cavesLezet/buoy_v2/README.md

# buoy_v2
версия 2 с нагревом панелей и 100500 датчиками температуры
