cavesLezet/buoy_v2/моделирование заряда затвора/Новый точечный рисунок (2).bmp

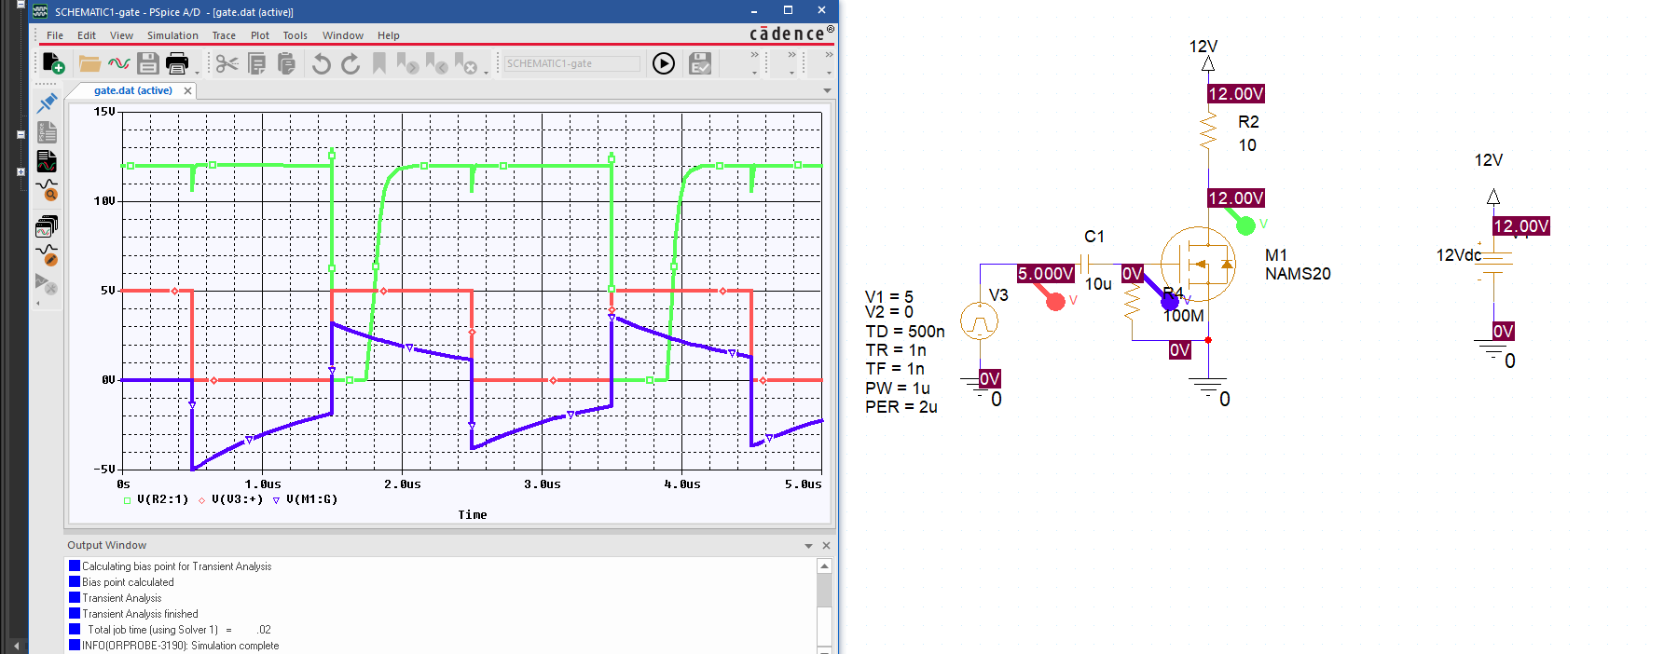
моделирование заряда затвора/Новый точечный рисунок (2).bmp
