cavesLezet/buoy_v2/моделирование заряда затвора/Новый точечный рисунок.bmp

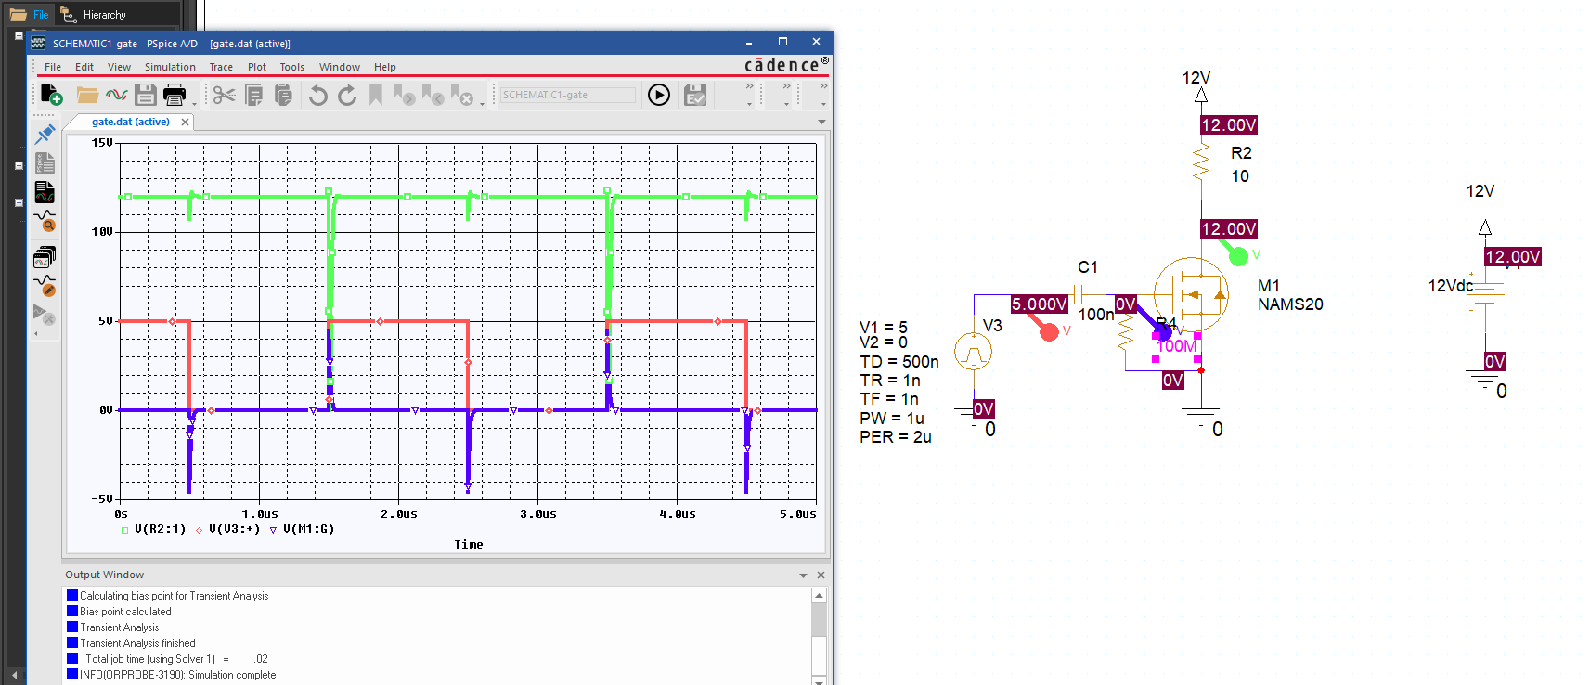
моделирование заряда затвора/Новый точечный рисунок.bmp
