cavesLezet/buoy_v2/моделирование источника тока на тл431/TL431.png

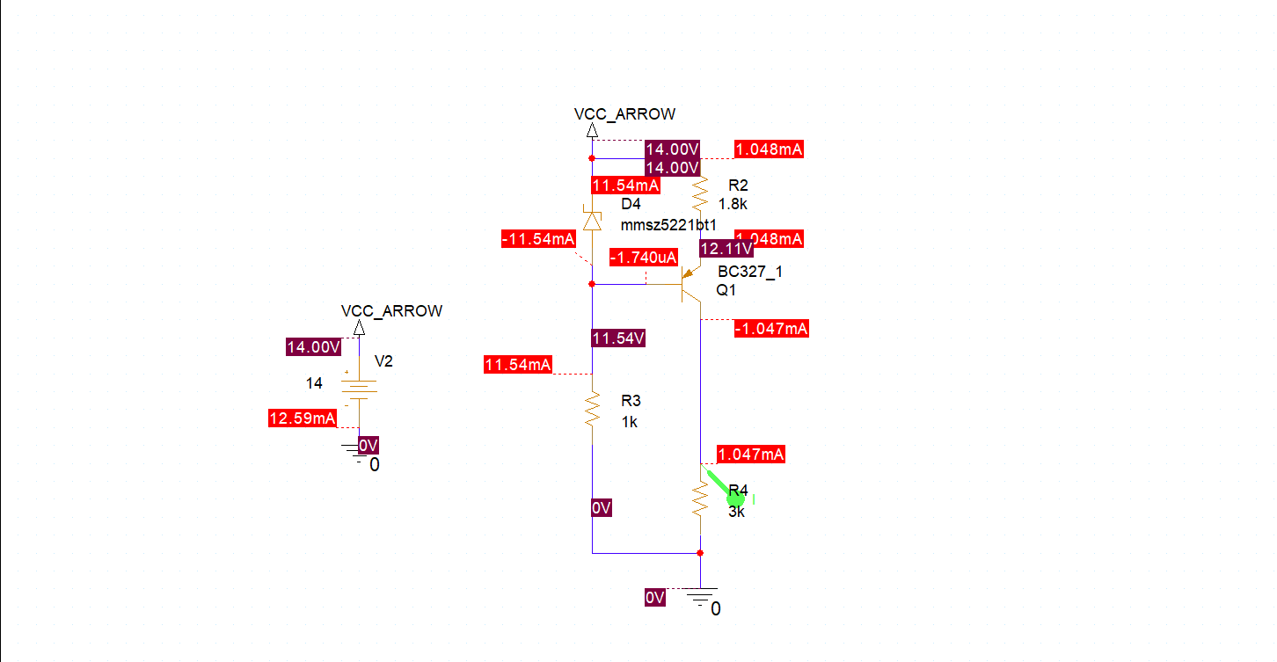
моделирование источника тока на тл431/TL431.png
