cavesLezet/buoy_v2/моделирование источника тока на тл431/Безымянный.png

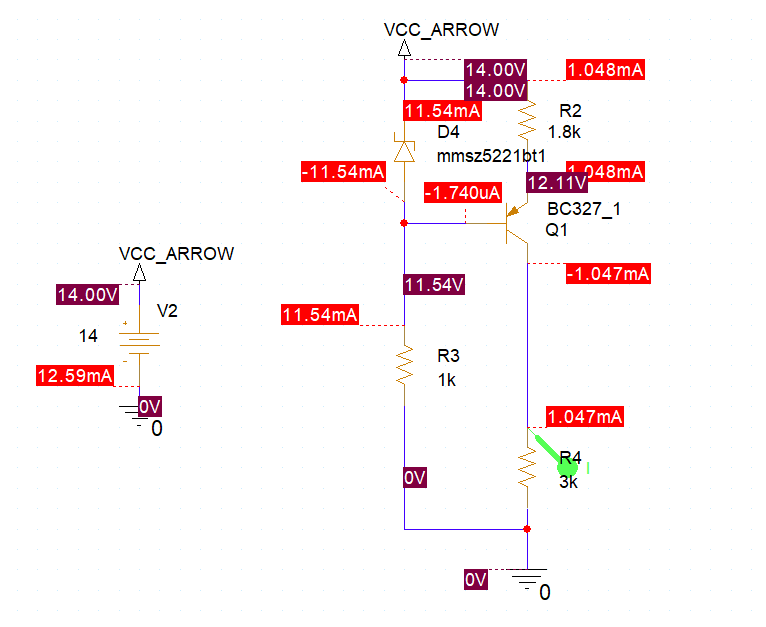
моделирование источника тока на тл431/Безымянный.png
