cavesLezet/buoy_v2/Project Outputs for buoy_v2.0_AA/buoy_v2.0_AA.xlsx

Part Number | Value | Footprint | Line # | Name | Description | Designator | Quantity | Manufacturer 1 | Manufacturer Part Number 1 | Manufacturer Lifecycle 1 | Supplier 1 | Supplier Part Number 1 | Supplier Unit Price 1 | Supplier Subtotal 1
10S45SP |  | TO-277 |  | 10S45SP | Диод шоттки на 45 В, ном. ток 10 А | VD19 | 1
15MQ040N |  | SMA |  | 15MQ040N | Диод шоттки на 40 В, ном. ток 2.1 А | VD14, VD16, VD17 | 3
74HC4051PW,118 |  | TSSOP-16 |  | 74HC4051PW,118 | Мультиплексор аналоговый 8 в 1 КМОП кристалл, TSSOP16 | DD7 | 1
ADM2483BRWZ |  | SOIC-16W |  | ADM2483BRWZ | Прием передатчик RS485 с гальванической развязкой | DD6 | 1
arduino_nano |  | arduino_nano |  | arduino_nano | ардуинка на стойках | DD2 | 1
B82462G4223M | 22 мк | B82462G4 |  | B82462G4223M | ЧИП-индуктивность 22мкГн, 1.05A, ±20% катушка | L2, L3, L5, L6 | 4
BAT54WS |  | SOD-323 |  | BAT54WS | Диод шоттки на 30 В, ном. ток 0.2 А | VD15, VD18 | 2
bc807 |  | SOT23-3 |  | bc807 | Биполярный транзистор PNP 45В 0.5А 0.31Вт | VT1 | 1
BZV55B2V4 | 2.4 В | mini_MELF_3.5mm |  | BZV55B2V4 | Стабилитрон на 2.4 В, рассеиваемая мощность 0.5 Вт | VD3 | 1
Capacitor_0,1u_10_50V_X7R_0603C | 0,1 мк | 0603C |  | Capacitor | Конденсатор | C3, C6, C7, C8, C9, C10, C11, C12, C13, C14, C16 | 11
Capacitor_1n_10_50V_X7R_0603C | 1 н | 0603C |  | Capacitor | Конденсатор | C27_1, C27_2, C27_3 | 3
Capacitor_1u_10_50V_X7R_0603C | 1 мк | 0603C |  | Capacitor | Конденсатор | C15, C24_1, C24_2, C24_3, C25_1, C25_2, C25_3 | 7
Capacitor_4,7u_10_50V_X7R_1206C | 4,7 мк | 1206C |  | Capacitor | Конденсатор | C28, C31, C33, C34, C37, C40, C42, C43 | 8
Capacitor_10n_10_50V_X7R_0603C | 10 н | 0603C |  | Capacitor | Конденсатор | C32, C41 | 2
Capacitor_10u_10_35V_X7R_1210C | 10 мк | 1210C |  | Capacitor | Конденсатор | C17_1, C17_2, C17_3, C18_1, C18_2, C18_3, C19_1, C19_2, C19_3, C20_1, C20_2, C20_3, C21_1, C21_2, C21_3, C22_1, C22_2, C22_3, C23_1, C23_2, C23_3 | 21
Capacitor_22u_10_25V_X7R_1210C | 22 мк | 1210C |  | Capacitor | Конденсатор | C2, C5, C29, C30, C35, C36, C38, C39, C44, C45 | 10
Capacitor_33n_10_50V_X7R_0603C | 33 н | 0603C |  | Capacitor | Конденсатор | C26_1, C26_2, C26_3 | 3
Capacitor_2200u_10V_10x20 | 2200 мк | 10x20_radial |  | Capacitor | Конденсатор радиальный 2200мкФ 10В ±20% 10*19 | C4 | 1
DHT22 |  | DHT22 |  | DHT22 | Датчик температуры и влажности на базе AM2302 | DD8 | 1
DIN41612_32_2row_right_angle_father |  | DIN41612_32_2row_right_angle_father |  | DIN41612_32_2row_right_angle_father | DIN41612R (DS1118-32M0R23), Разъем (вилка) тип B 32pin (2х16), шаг 2.54мм двухрядный угловой (ряд АВ) | XP1 | 1
EEVFK1E102Q | 1000 мк | SMD_cap_12,5x13,5 |  | Capacitor | Конденсатор алюминиевый электролитический 1000мкФ 25В 20% Low ESR 1100мА SMD12.5x13.5мм | C1 | 1
Fuse 20x5 on clips FC-M | {Номинал} | fuse_20x5_on_clips_FC-M |  | Fuse 20x5 on clips FC-M | Предохранитель 20*5 на креплениях | F1 | 1
IHLP2525CZER4R7M01 | 4,7 мк | IHLP-2525 |  | IHLP2525CZER4R7M01 | ЧИП-индуктивность экранированная 4,7мкГн ±20% 5,5A 40мОм 2525 | L1_1, L1_2, L1_3 | 3
IHLP4040DZER220M11 | 22 мк | IHLP-4040 |  | IHLP4040DZER220M11 | ЧИП-индуктивность экранированная 22мкГн ±20% 5A 66мОм 4040 лента на катушке | L4 | 1
IHLP4040DZER330M11 | 33 мк | IHLP-4040 |  | IHLP4040DZER330M11 | ЧИП-индуктивность экранированная 33мкГн ±20% 4,4A 94,5мОм 4040 | L7 | 1
MAX485CSA |  | SOIC-8 |  | MAX485CSA | RS-485 приёмопередатчик | DD4 | 1
MC74HC595ADR2G |  | SOIC-16 |  | MC74HC595ADR2G | 8-ми битный сдвиговый регистр | DD3, DD5 | 2
MT3608 |  | SOT23-6 |  | MT3608 | Повышающий/SEPIC DC-DC преобразователь 2А 1.2МГц | DD9, DD10 | 2
PESD5V0S1UB | 5 В | SOD523 |  | PESD5V0S1UB | Защитный диод на 5 В, рассеиваемая мощность 330 Вт | VD2, VD4, VD5, VD6, VD7, VD8, VD10, VD13_1, VD13_2, VD13_3, VD13_4, VD13_5, VD13_6, VD13_7 | 14
PSM712 |  | SOT23-3 |  | PSM712 | Защитный диод для линии RS-485 | D1, D2 | 2
Resistor_1.0k_1_0603 | 1,0 к | 0603R |  | Resistor | Резистор номиналом 1,0 кОм и точностью 1% | R1, R4, R10, R25, R26, R33_1, R33_2, R33_3, R33_4, R33_5, R33_6, R33_7, R35_1, R35_2, R35_3, R35_4, R35_5, R35_6, R35_7, R39_1, R39_2, R39_3, R39_4, R39_5, R39_6, R39_7, R42, R45, R52 | 29
Resistor_1.8k_1_0603 | 1,8 к | 0603R |  | Resistor | Резистор номиналом 1,8 кОм и точностью 1% | R2 | 1
Resistor_5.1k_1_0603 | 5,1 к | 0603R |  | Resistor | Резистор номиналом 5,1 кОм и точностью 1% | R11, R40_1, R40_2, R40_3, R40_4, R40_5, R40_6, R40_7 | 8
Resistor_10_1_0603 | 10 | 0603R |  | Resistor | Резистор номиналом 10 Ом и точностью 1% | R3, R5, R7, R8, R9, R12, R13, R14, R16, R17, R18, R28_1, R28_2, R28_3 | 14
Resistor_10k_1_0603 | 10 к | 0603R |  | Resistor | Резистор номиналом 10 кОм и точностью 1% | R6, R22, R31_1, R31_2, R31_3, R37_1, R37_2, R37_3, R37_4, R37_5, R37_6, R37_7, R41, R48, R49 | 15
Resistor_15k_1_0603 | 15 к | 0603R |  | Resistor | Резистор номиналом 15 кОм и точностью 1% | R23, R24, R32_1, R32_2, R32_3, R32_4, R32_5, R32_6, R32_7, R34_1, R34_2, R34_3, R34_4, R34_5, R34_6, R34_7, R38_1, R38_2, R38_3, R38_4, R38_5, R38_6, R38_7 | 23
Resistor_18k_1_0603 | 18 к | 0603R |  | Resistor | Резистор номиналом 18 кОм и точностью 1% | R21 | 1
Resistor_31.6k_1_0603 | 31,6 к | 0603R |  | Resistor | Резистор номиналом 31,6 кОм и точностью 1% | R54 | 1
Resistor_56k_1_0603 | 56 к | 0603R |  | Resistor | Резистор номиналом 56 кОм и точностью 1% | R30_1, R30_2, R30_3 | 3
Resistor_100k_1_0603 | 100 к | 0603R |  | Resistor | Резистор номиналом 100 кОм и точностью 1% | R15, R46, R53 | 3
Resistor_120_1_0603 | 120 | 1206R |  | Resistor | Резистор номиналом 120 Ом и точностью 1% | R19, R20 | 2
Resistor_130k_1_0603 | 130 к | 0603R |  | Resistor | Резистор номиналом 130 кОм и точностью 1% | R27_1, R27_2, R27_3 | 3
Resistor_470_1_0603 | 470 | 0603R |  | Resistor | Резистор номиналом 470 Ом и точностью 1% | R43, R50 | 2
Resistor_510_1_0603 | 510 | 2512R |  | Resistor | Резистор номиналом 510 Ом и точностью 1% | R36_1, R36_2, R36_3, R36_4, R36_5, R36_6, R36_7 | 7
RT8279GSP |  | 8SOP(Exposed_Pad) |  | RT8279GSP | Преобразователь постоянного тока понижающий подстраиваемый выход 5А | DA7, DA8 | 2
RT8509A |  | WDFN5x5-12 |  | RT8509A | Импульсный повышающий DC-DC стабилизатор, регулируемый, 2.8В-14В (Vin), 24В/4.5A, 1.5МГц, WDFN-12 | DA3_1, DA3_2, DA3_3 | 3
SB |  | 0805SB, 1206SB |  | SB | Solder bridge, мост припоя, запаиваемая перемычка, net tie, jumper | SB1, SB2, SB3, SB4, SB5, SB6, SB7 | 7
sim800l |  | sim800l |  | sim800l | Четырехдиапазонный GSM/GPRS модуль, частоты: GSM 850 МГц, EGSM 900 МГц, DCS 1800 МГц и PCS 1900 МГц. | DD1 | 1
SK810 |  | SMC |  | SK810 | Диод шоттки на 100 В, ном. ток 8 А | VD12_1, VD12_2, VD12_3 | 3
SMAJ12CA | 12 В | SMA |  | SMAJ12CA | Защитный диод на 12 В, рассеиваемая мощность 400 Вт | VD9, VD11 | 2
SMBJ13A-TR | 13 В | SMB |  | SMBJ13A-TR | Защитный диод на 13 В, рассеиваемая мощность 600 Вт | VD1 | 1
TC33X-2-101E | 100 | 3mm_trim |  | TC33X-2-101E | Потенциометр керметный 100 Ом 0.1Вт для поверхностного монтажа | R44, R51 | 2
TC33X-2-102E | 1 к | 3mm_trim |  | TC33X-2-102E | Потенциометр керметный 1кОм 0.1Вт для поверхностного монтажа | R47 | 1
TC33X-2-503E | 50 к | 3mm_trim |  | TC33X-2-503E | Потенциометр однооборотный керметный 50кОм 0.1Вт ±25% SMD лента на катушке | R29_1, R29_2, R29_3 | 3
UMW TL431 0.5% |  | SOT23-3 |  | UMW TL431 0.5% | Источник опорного напряжения , программируемый стабилитрон [SOT-23-3] | U1 | 1
VN7140AS |  | SOP8 |  | VN7140AS | Силовой ключ верхнего плеча с аналоговой обратной связью MultiSense автомобильного применения | DA1, DA2, DA4_1, DA4_2, DA4_3, DA4_4, DA4_5, DA4_6, DA4_7, DA5_1, DA5_2, DA5_3, DA5_4, DA5_5, DA5_6, DA5_7, DA6_1, DA6_2, DA6_3, DA6_4, DA6_5, DA6_6, DA6_7 | 23
XT30PW-M |  | XT30PW-M |  | XT30PW-M | 30 А (15 продолжительно), 2 контакта разъем угловой отец | X1 | 1
