cavesLezet/buoy_v2/(threads)

Thread 1 (2024-11-28):

новая плата

cavesLezet, 2024-11-28:

cavesLezet, 2024-11-30:
**датчики темпы**
| что, ссылка | тип | Цена | Плюсы | Минусы
| --- | --- | --- | --- | --- |
[AD22100](https://www.chipdip.ru/product/ad22100kt-z) |

cavesLezet, 2024-12-02:
надо прикинуть че с ключами
заходит 1 панель, ее можно либо замкнуть на идеальную нагрузку либо на аккум. но надо её отмыкать от всего и подавать на нее 18в. получается можно выход дцдц повышающего прямо на панель чтобы он всегда висел, управлять энейблом дц дц
п.с энейблом нельзя, когда на тёмную панель подключается 12 в(они появляются на выходе выключенного дцдц из за его устройства) то через нее течет несколько милиампер
то есть 2 клбча на то чтобы панель лиьо к идеальной либо к аккуму, 1 ключ подает 18в

cavesLezet, 2024-12-15:
влажный датчик

cavesLezet, 2025-01-16:
https://github.com/cavesLezet/buoy_cross_board

cavesLezet, 2025-01-16:
кроссовая и сборка

cavesLezet, 2025-03-31:
можно здесь же ошибки писать
ареф не туда заведен

cavesLezet, 2025-08-11:
припаять все компоненты обратно на плату

cavesLezet, 2025-08-11:
подключить энейбл аналогового мультиплексора dd7 !en к выходу сдвигового dd5 qf (5)

cavesLezet, 2025-08-11:
сделать чтобы плата воскрешалась после смерти аккума

cavesLezet, 2025-08-12:
провести тесты на автономность, надо ли еще 7 панелей?

cavesLezet, 2025-08-13:
спиздить нагрузку и снять вах панелей

cavesLezet, 2025-08-14:
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

резисторы в цепи обратной связи домножил на 10 у 2х дцдц

cavesLezet, 2025-08-14:
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

резисторы в цепи обратной связи домножил на 10 у 2х дцдц

cavesLezet, 2025-08-14:
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

такая схема еще была сделана для непроеба точки макс мощности, юзался сепик преобразователь на мт3608, с мт3608л не заработало. резисторы умножить на 10

cavesLezet, 2025-08-16:
делитель аккума побольше сделать

cavesLezet, 2025-08-21:
пиздец ключи едят по 3-4ма во включенном состоянии

cavesLezet, 2025-08-30:
схема была модифицирована, защитил затворы п канальных, сделал автостарт зарядки панелей, чтоьы буй не умирал пр разрядке аккума
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

cavesLezet, 2025-09-04:
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
решается проблема вот так, диодами, пока отлаживал спалил транзистор 1, надо узнать насколько это системная проблема
