cavesLezet/buoy_v2/buoy_v2.0_AA.pdf

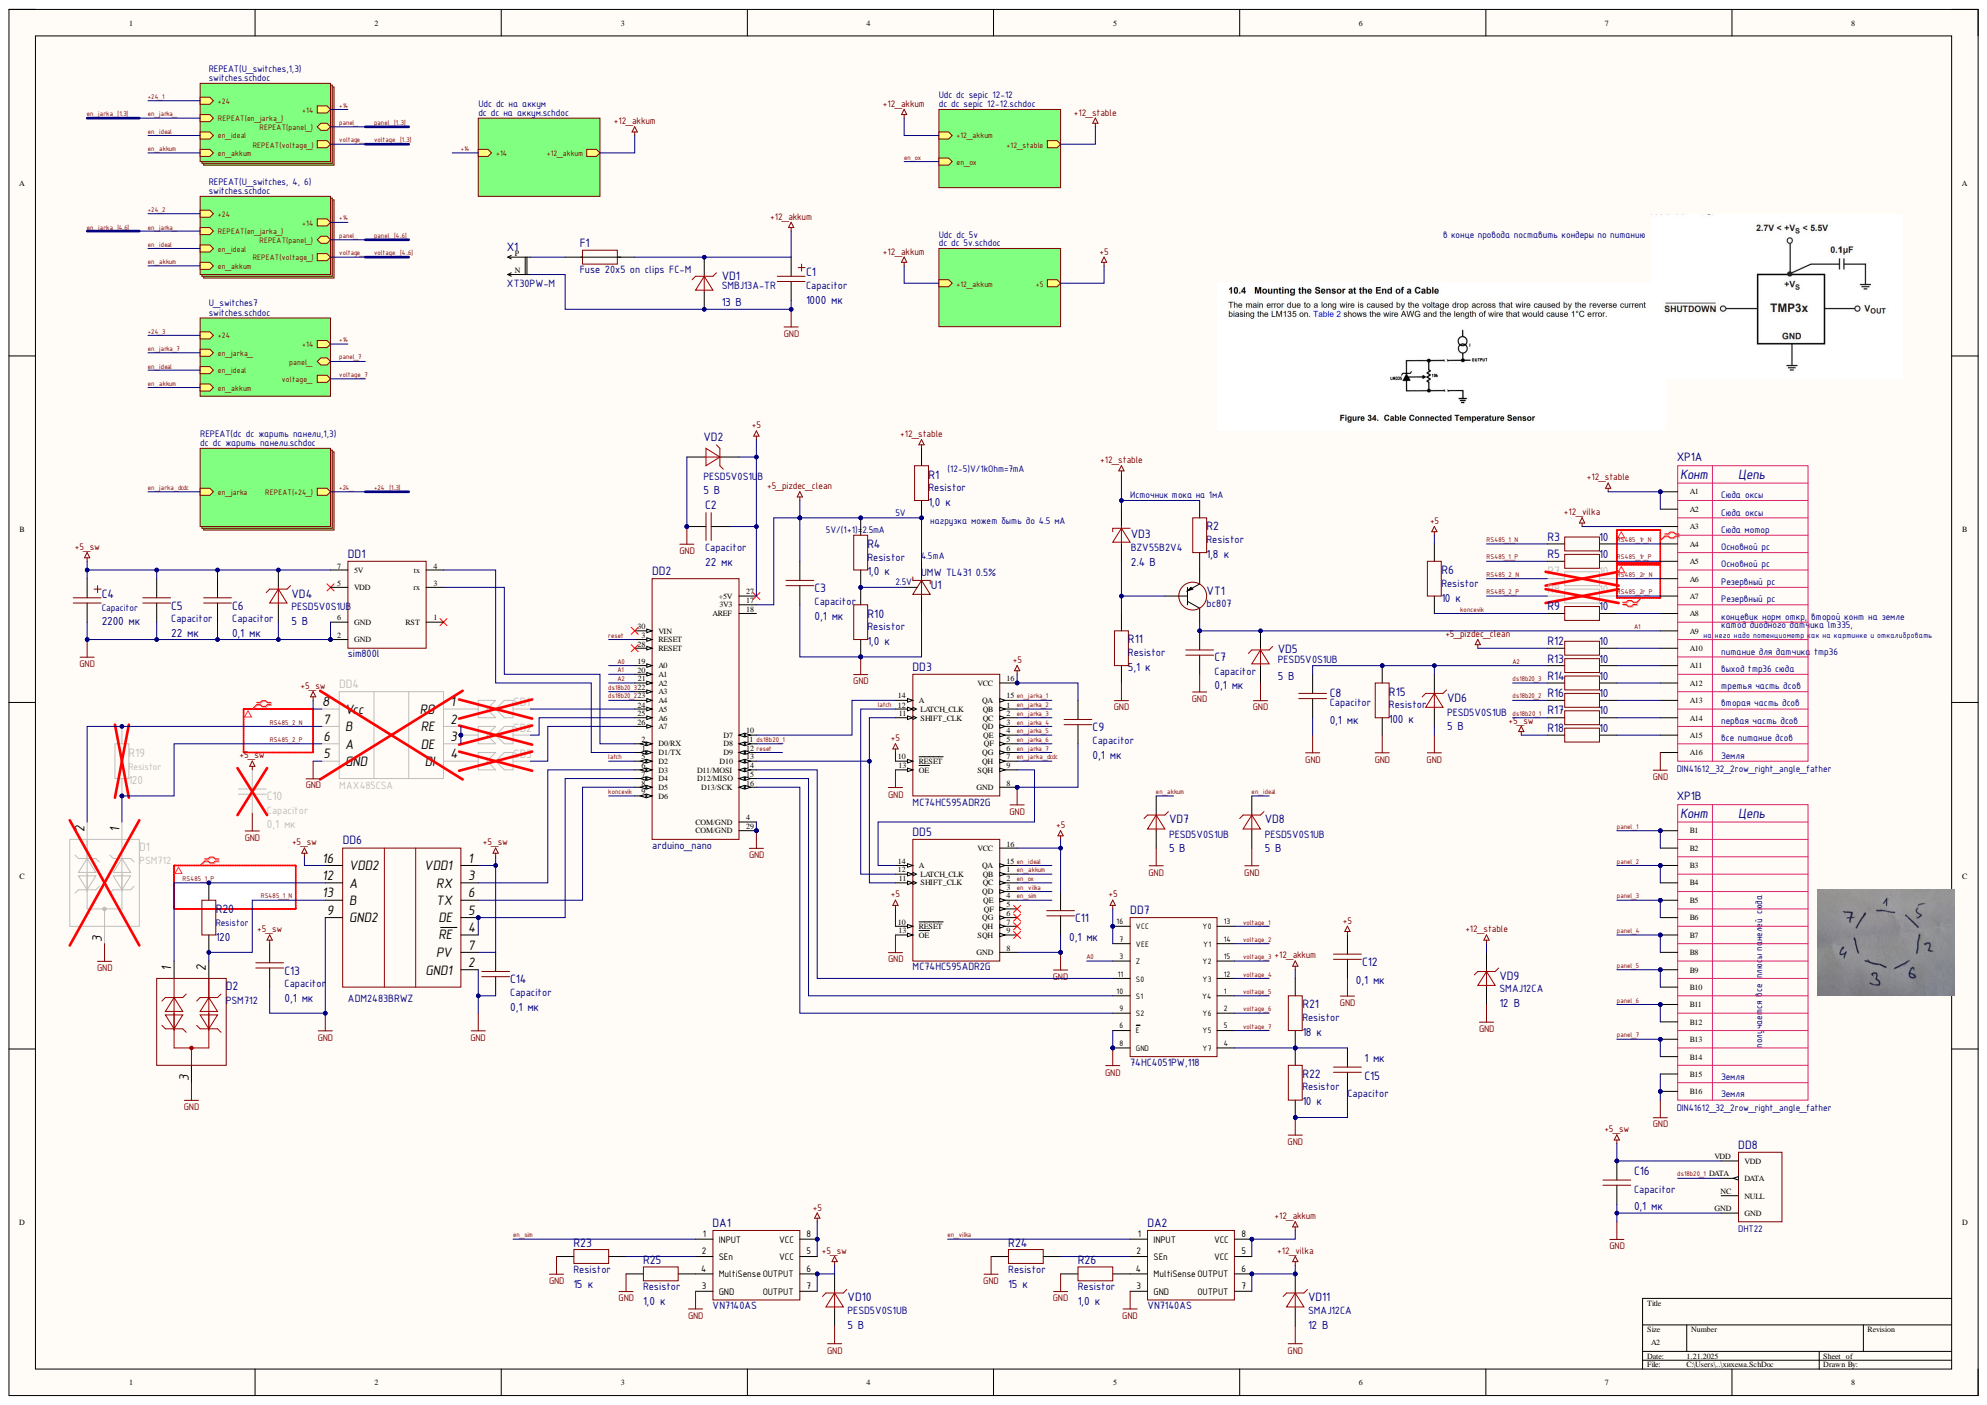
[picture p5: page 1]

Udc dc на аккум dc dc на аккум.schdoc +14

в конце провода поставить кондеры по питанию

Fuse 20x5 on clips FC-M

REPEAT(dc dc жарить панели,1,3) dc dc жарить панели.schdoc

Конт | Цепь

A1 | Сюда оксы

нагрузка может быть до 4.5 мА

A2 | Сюда оксы

получается все плюсы панелей сюда

B15 | Земля

B16 | Земля

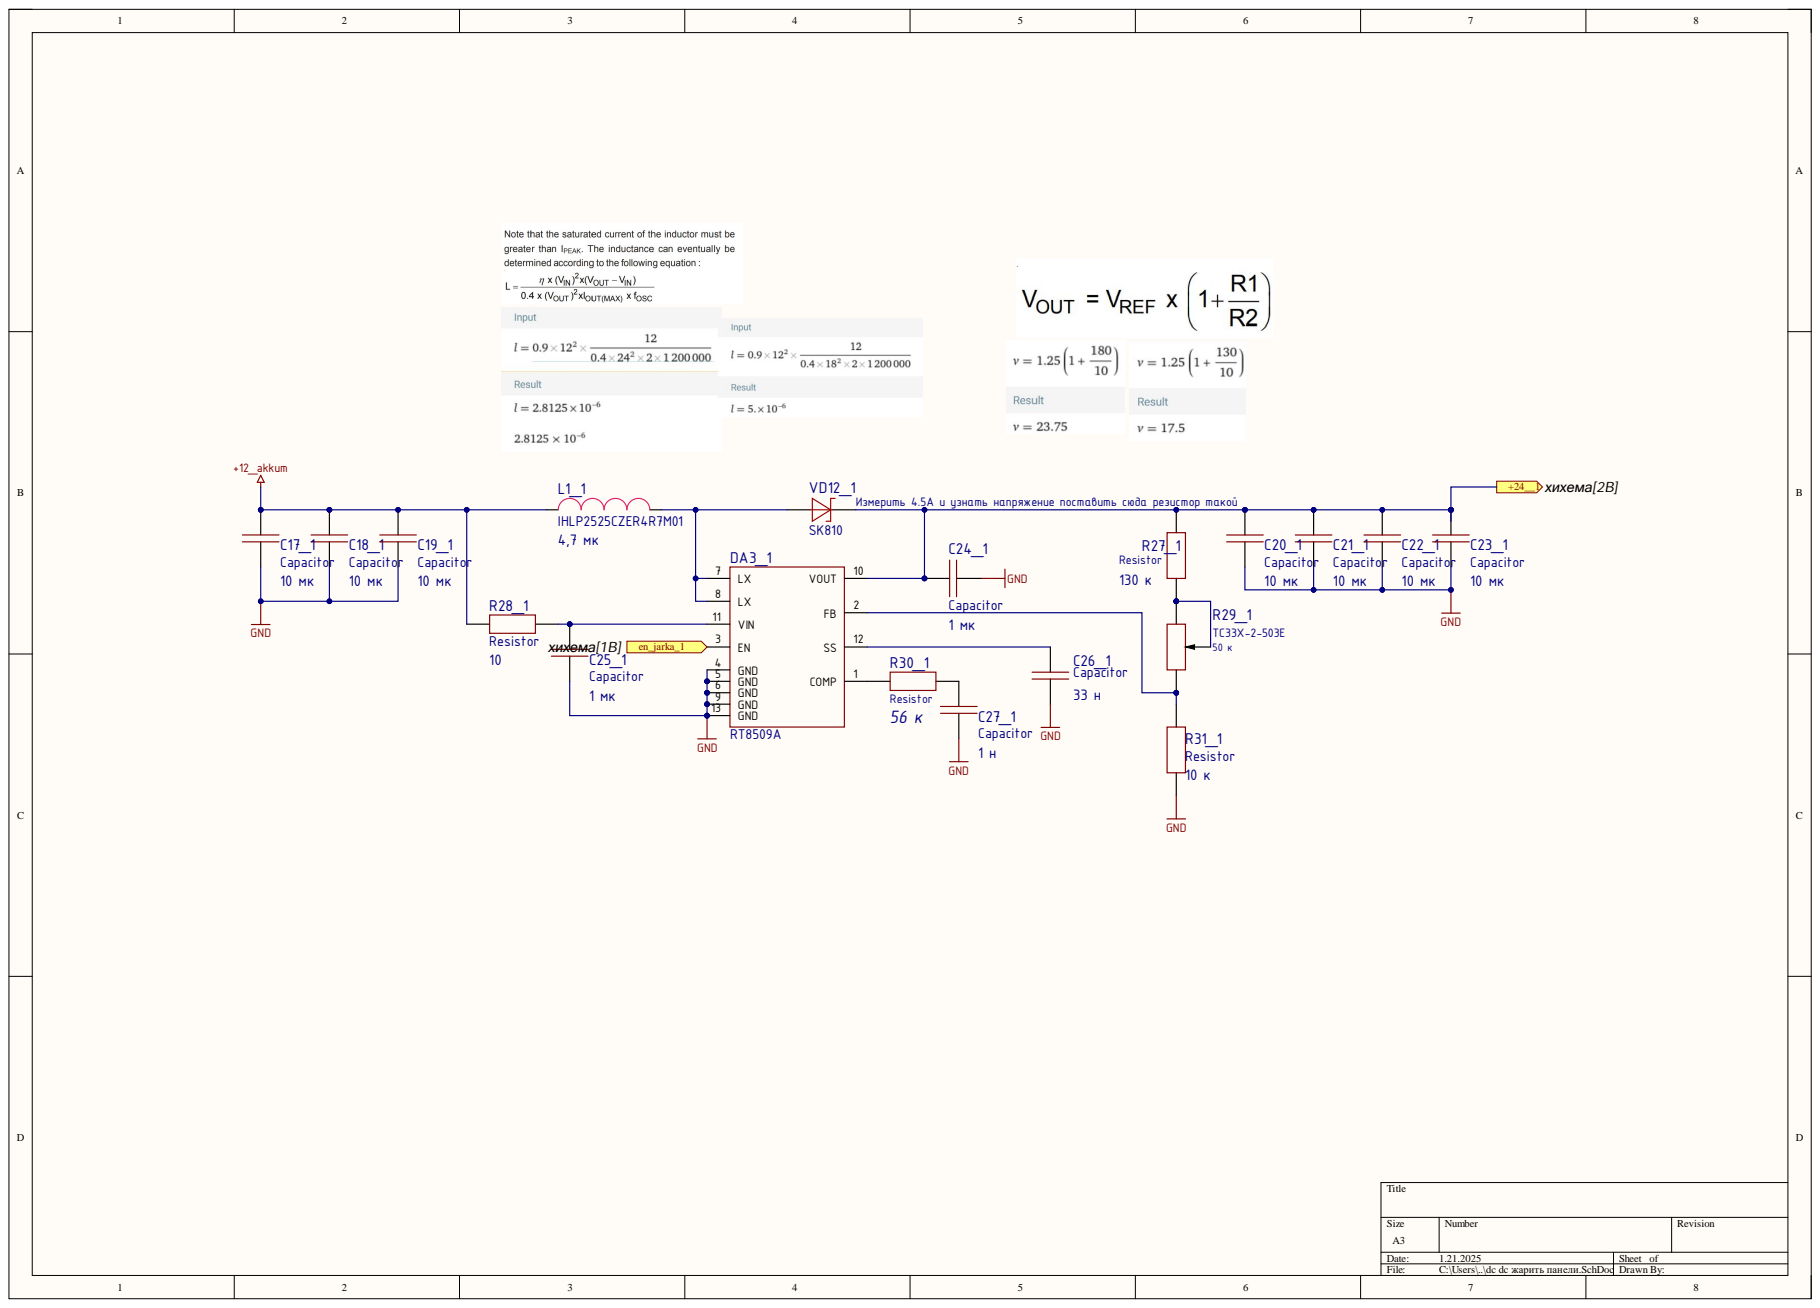
[picture p6: page 2]

Измерить 4.5А и узнать напряжение поставить сюда резистор такой

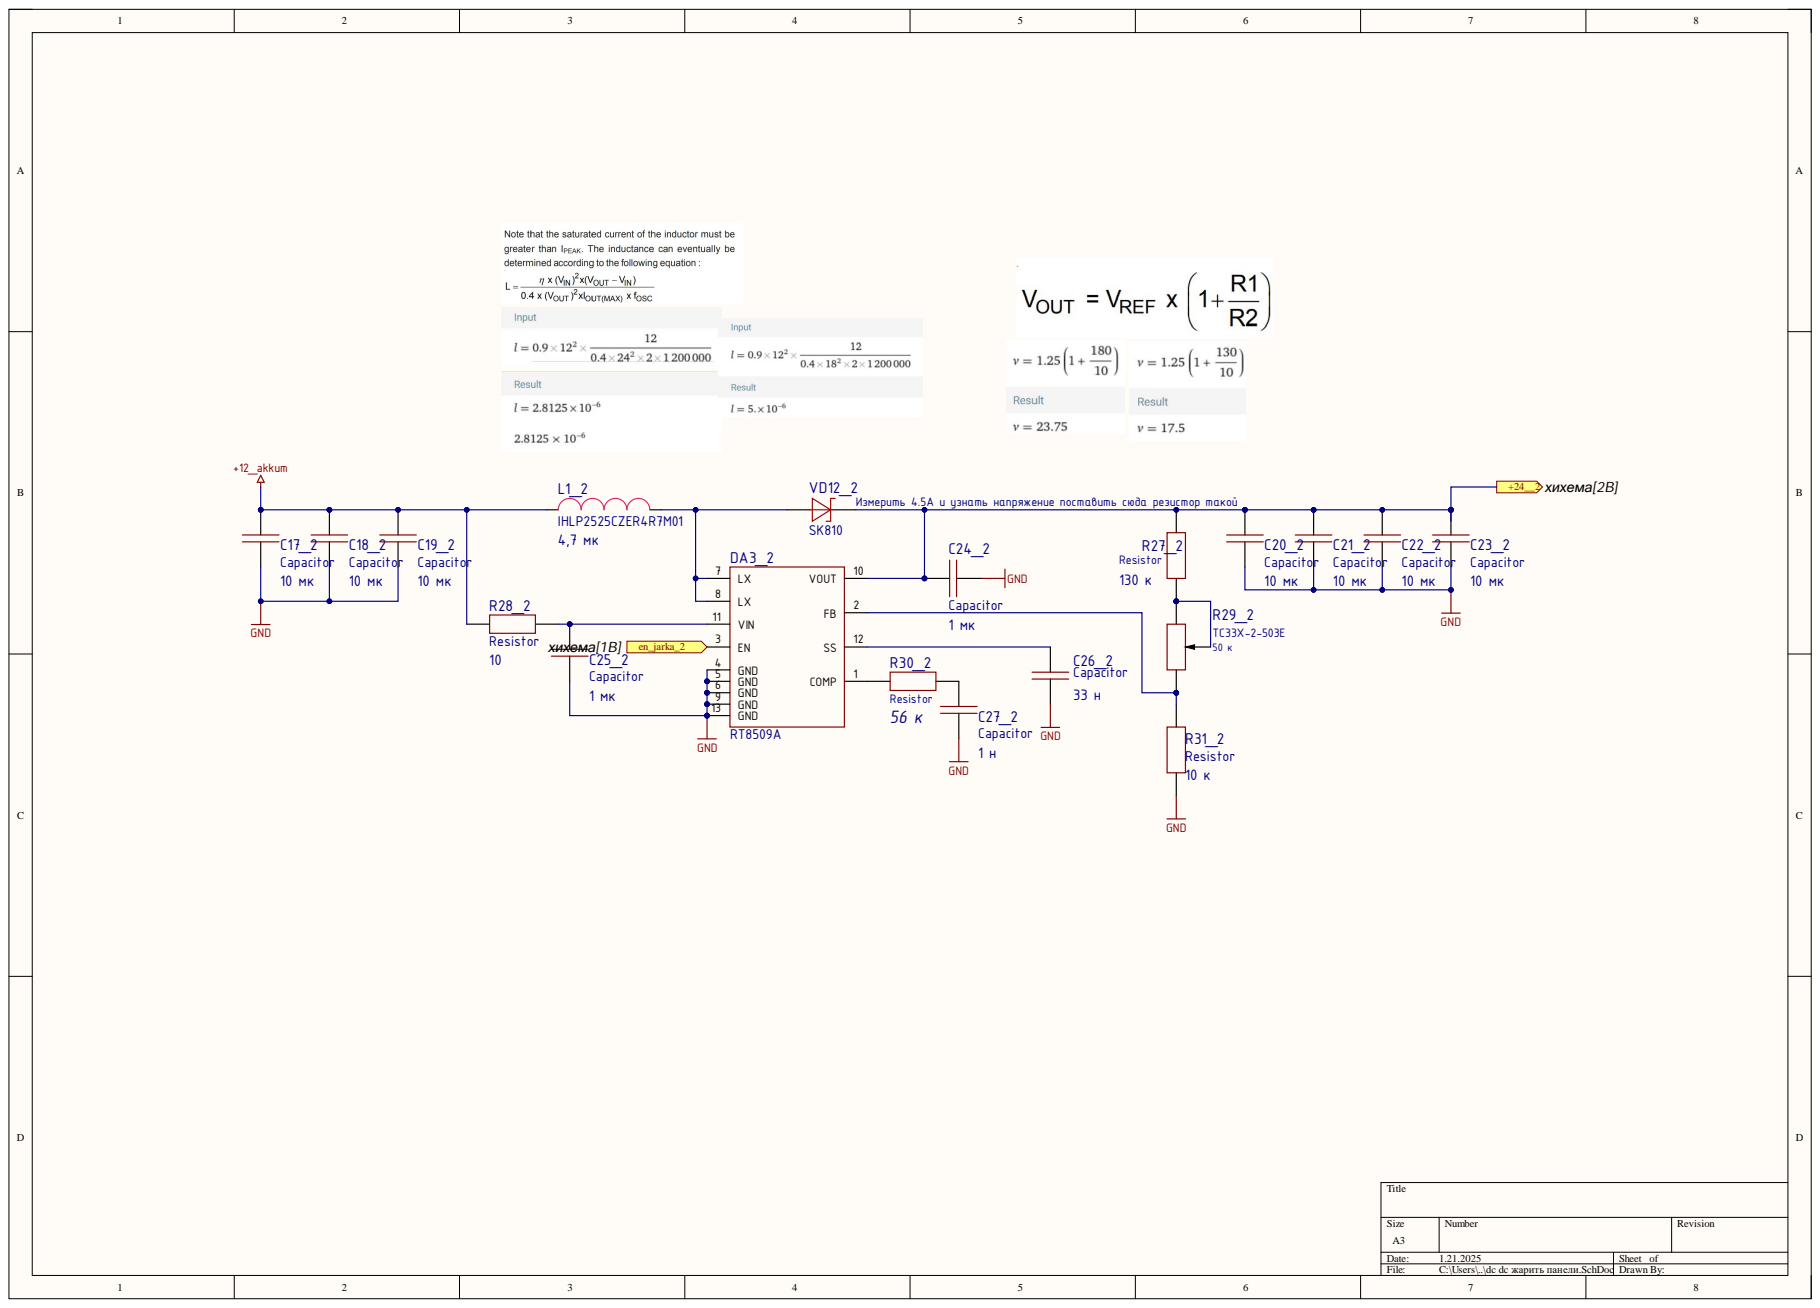
[picture p7: page 3]

Измерить 4.5А и узнать напряжение поставить сюда резистор такой

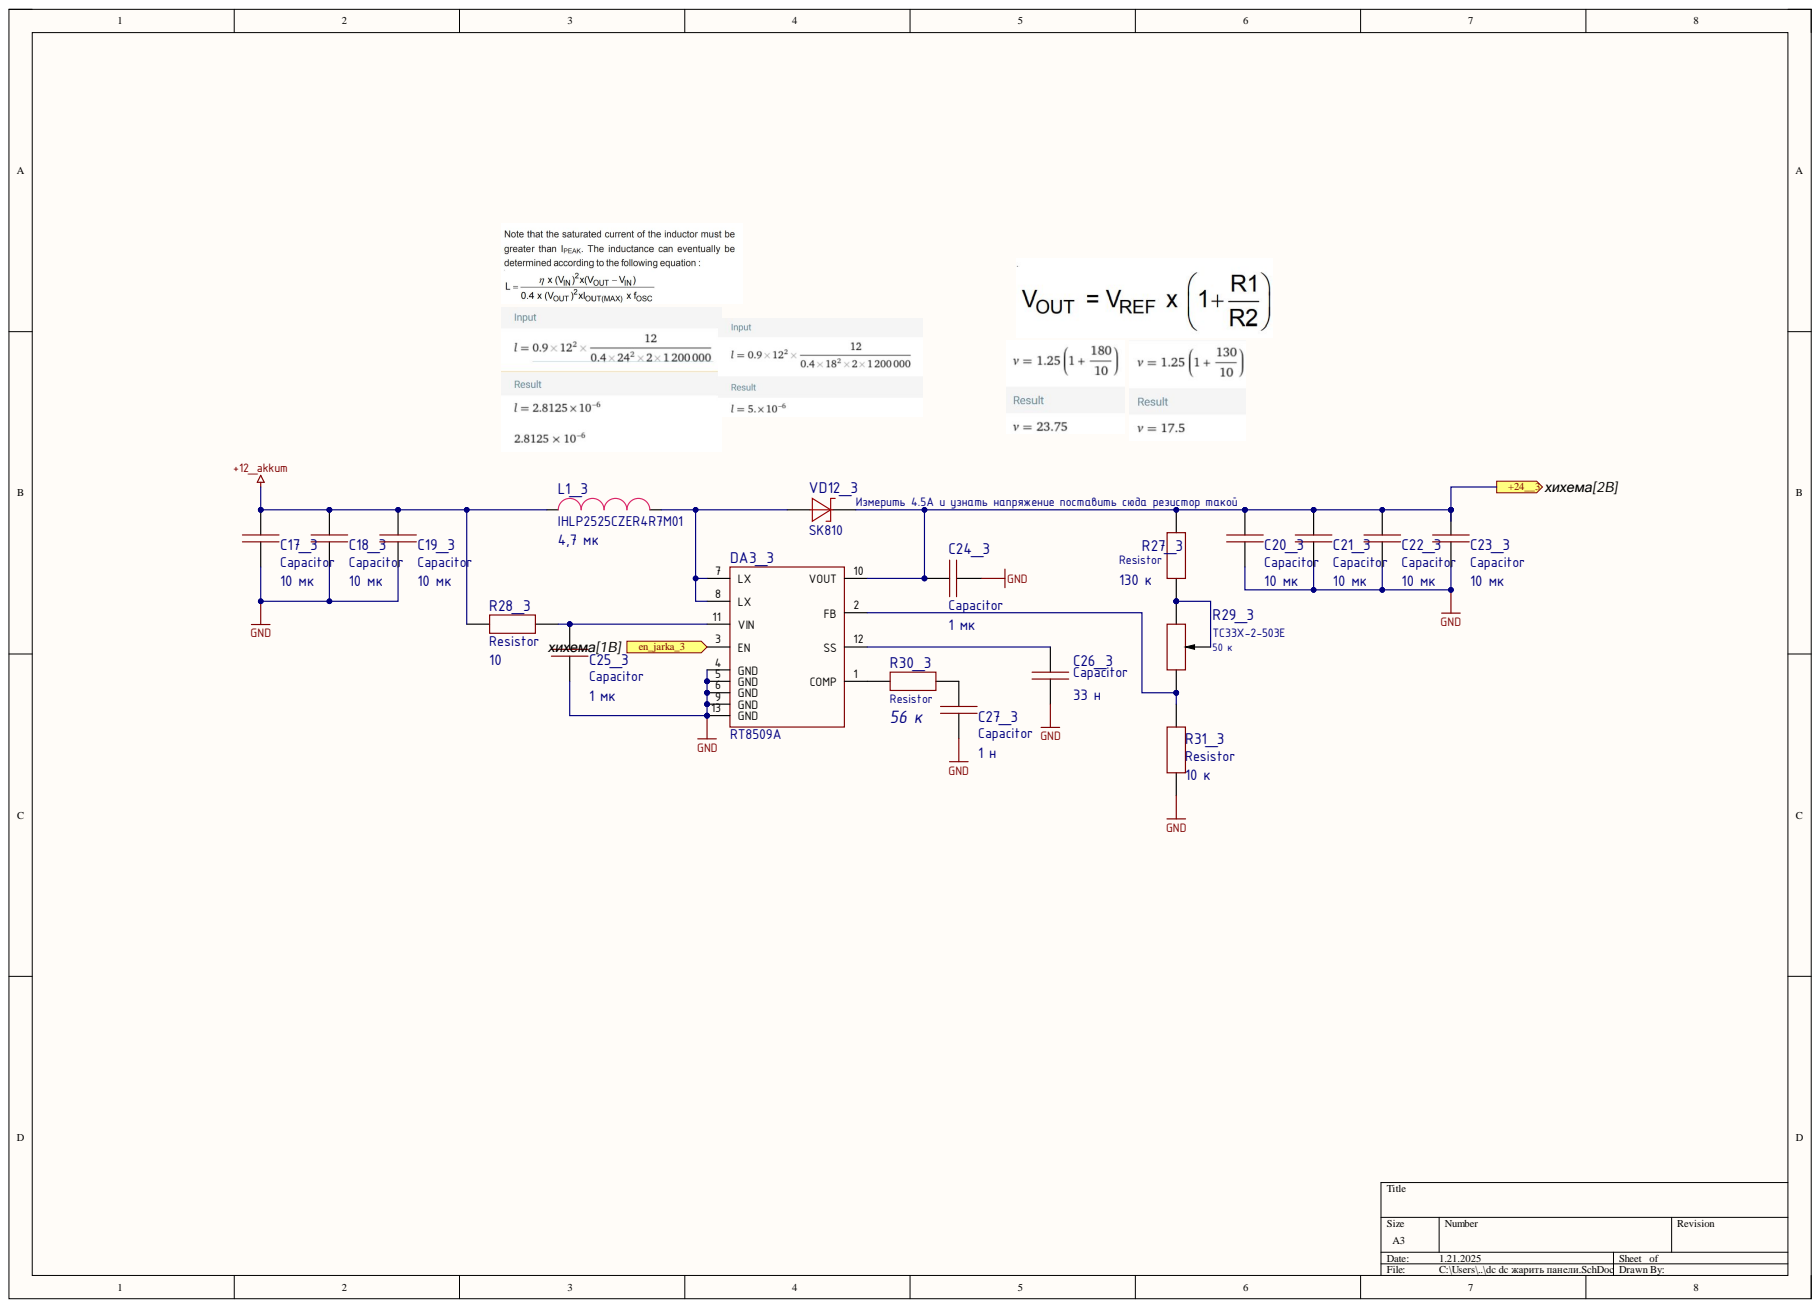
[picture p8: page 4]

Измерить 4.5А и узнать напряжение поставить сюда резистор такой

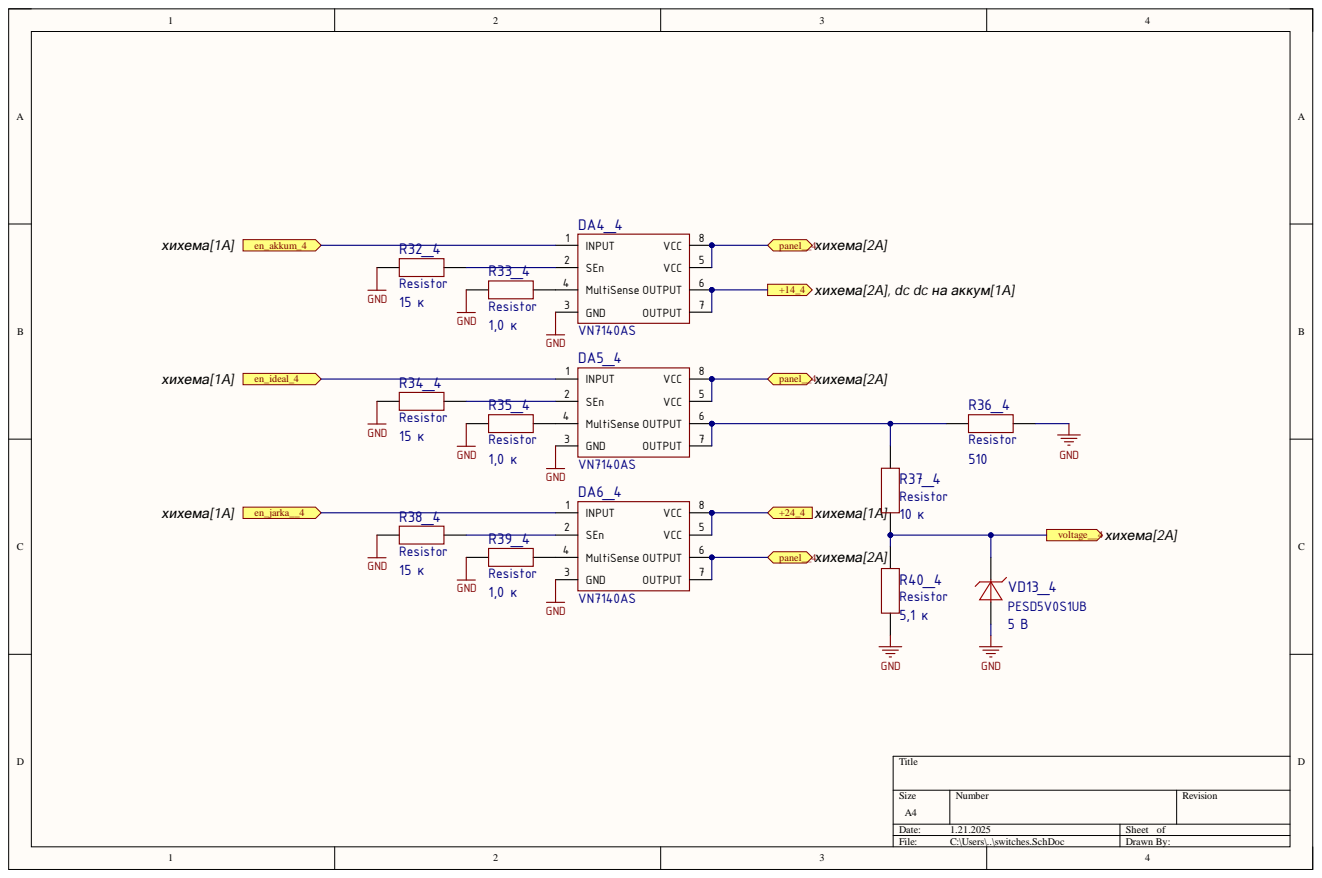
[picture p9: page 5]

+14_4 хихема[2A], dc dc на аккум[1A]

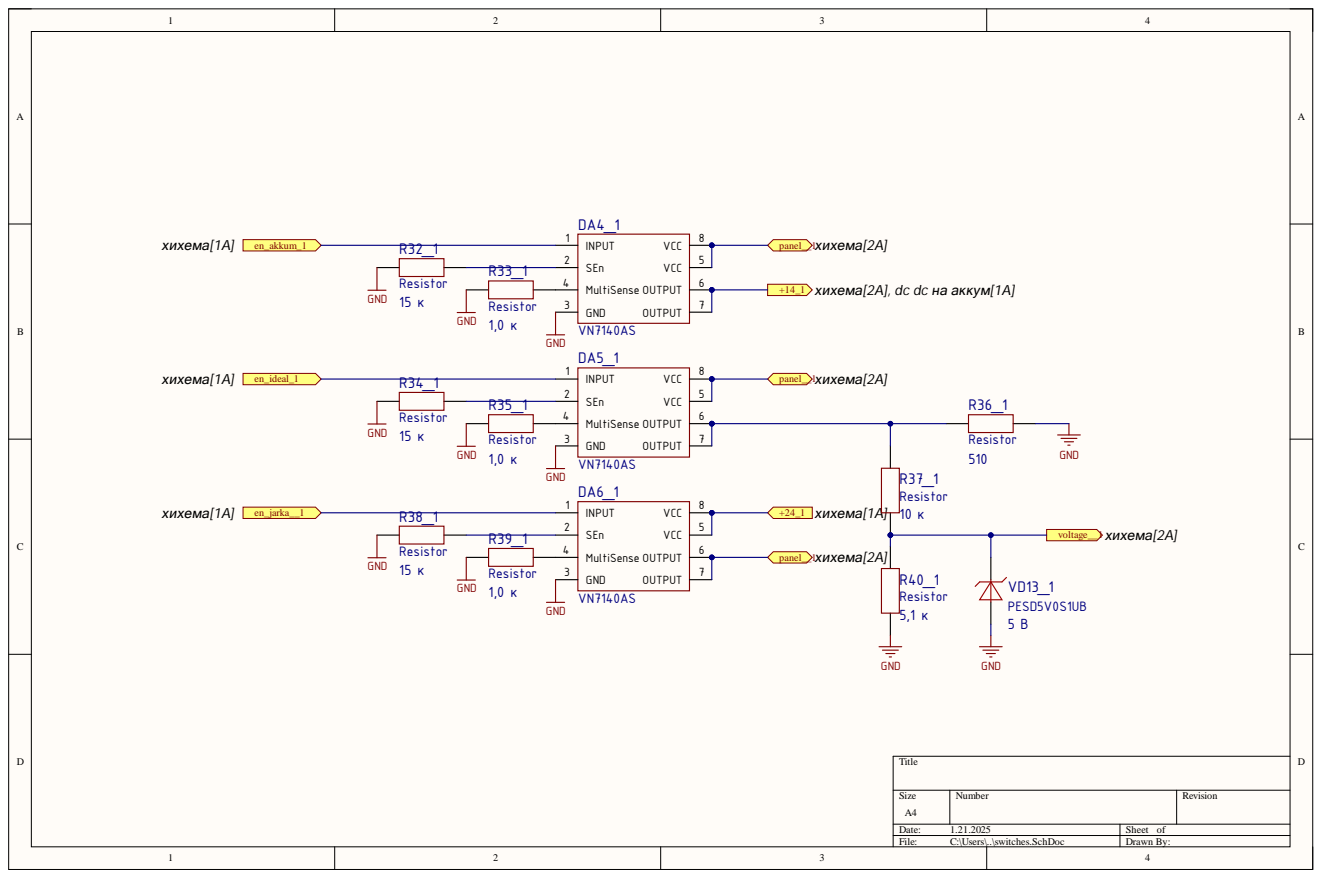
[picture p10: page 6]

+14_1 хихема[2A], dc dc на аккум[1A]

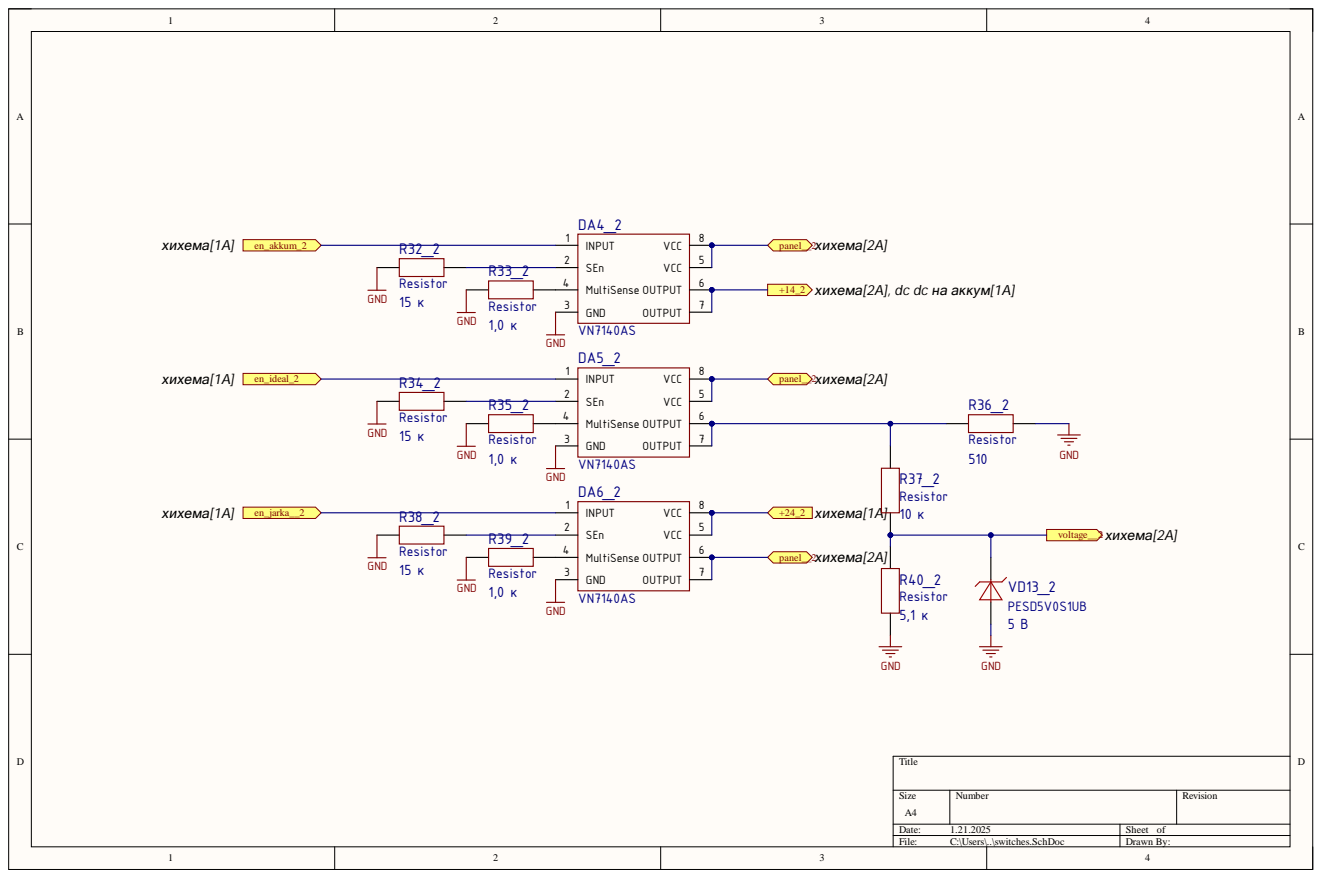
[picture p11: page 7]

+14_2 хихема[2A], dc dc на аккум[1A]

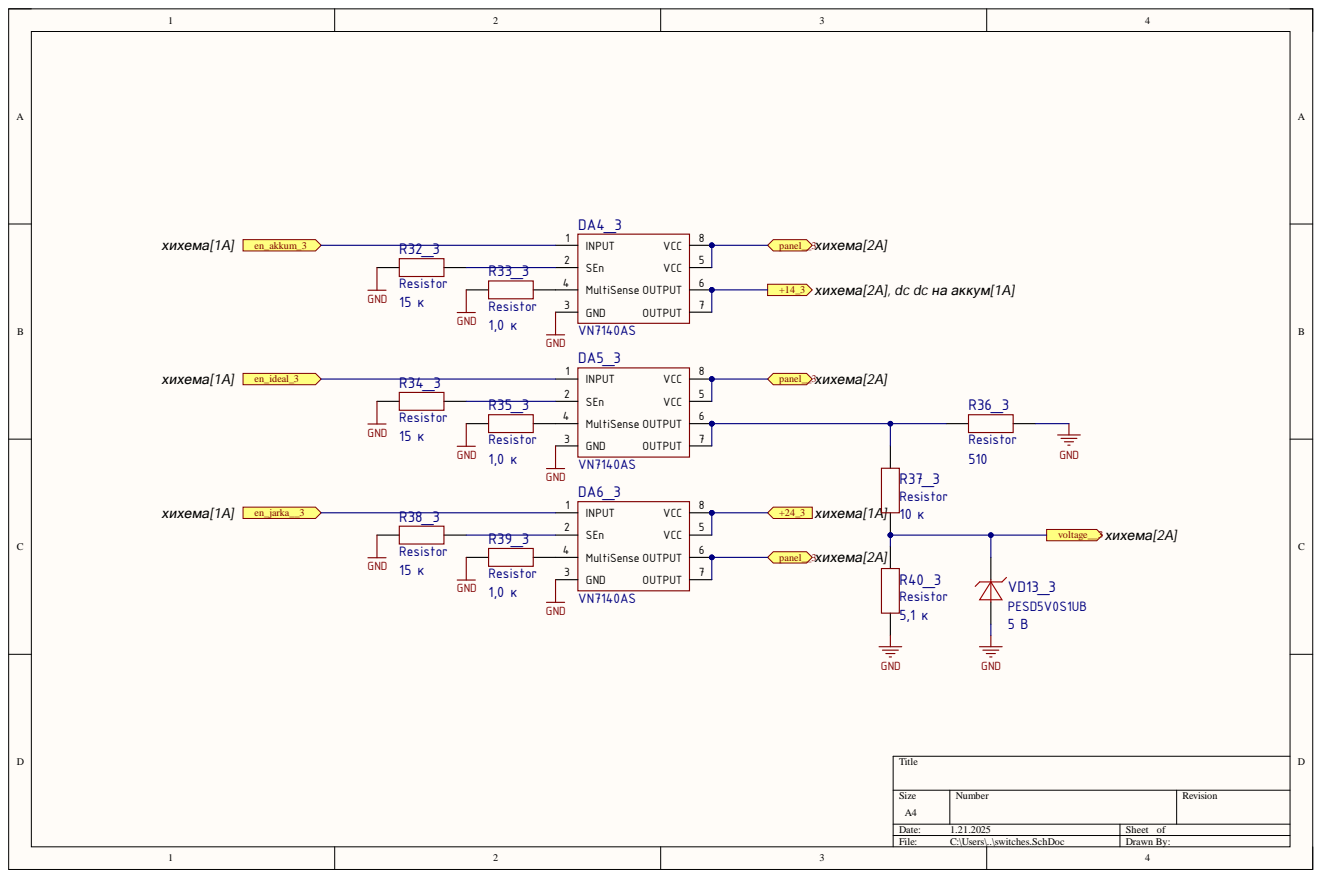
[picture p12: page 8]

+14_3 хихема[2A], dc dc на аккум[1A]

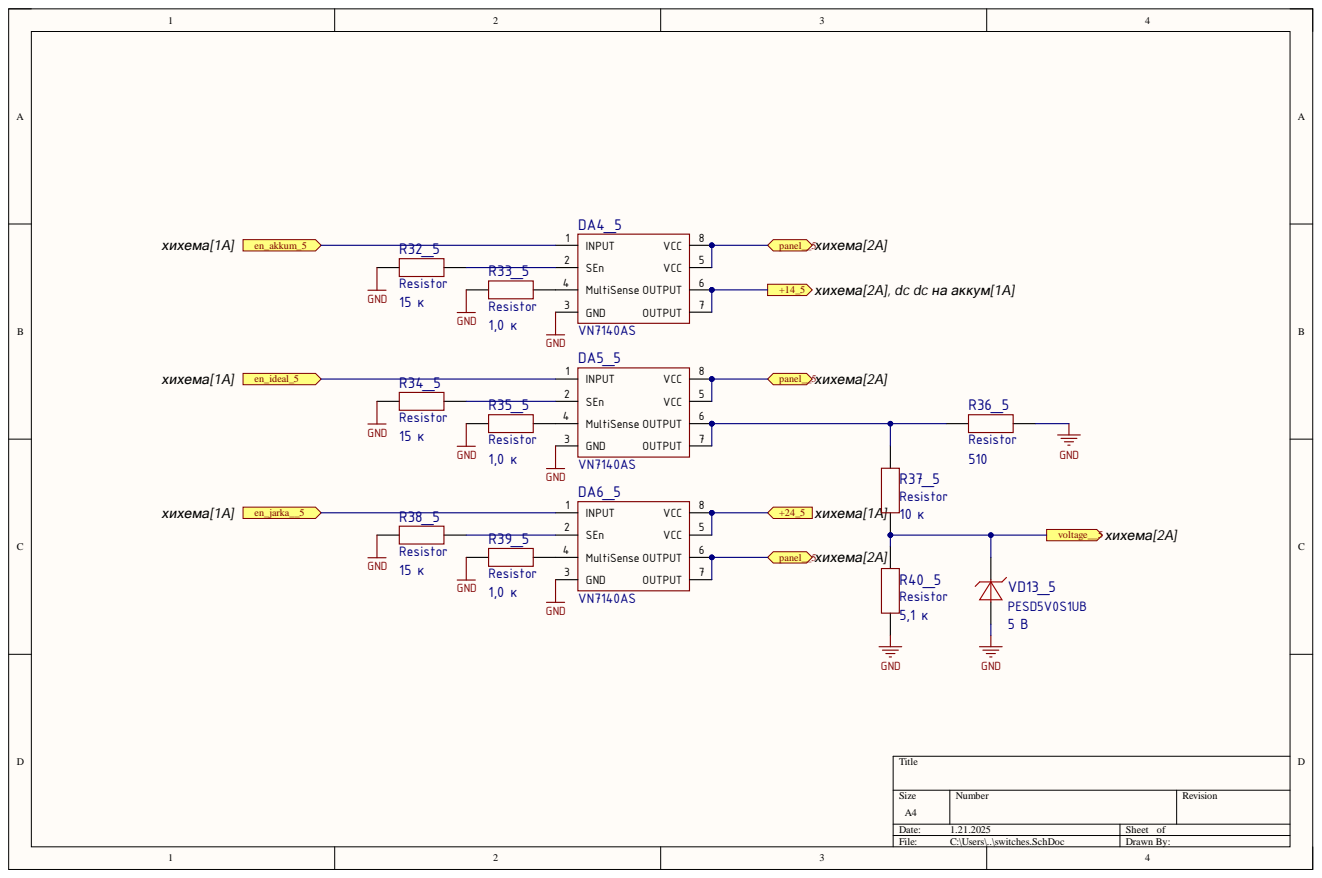
[picture p13: page 9]

+14_5 хихема[2A], dc dc на аккум[1A]

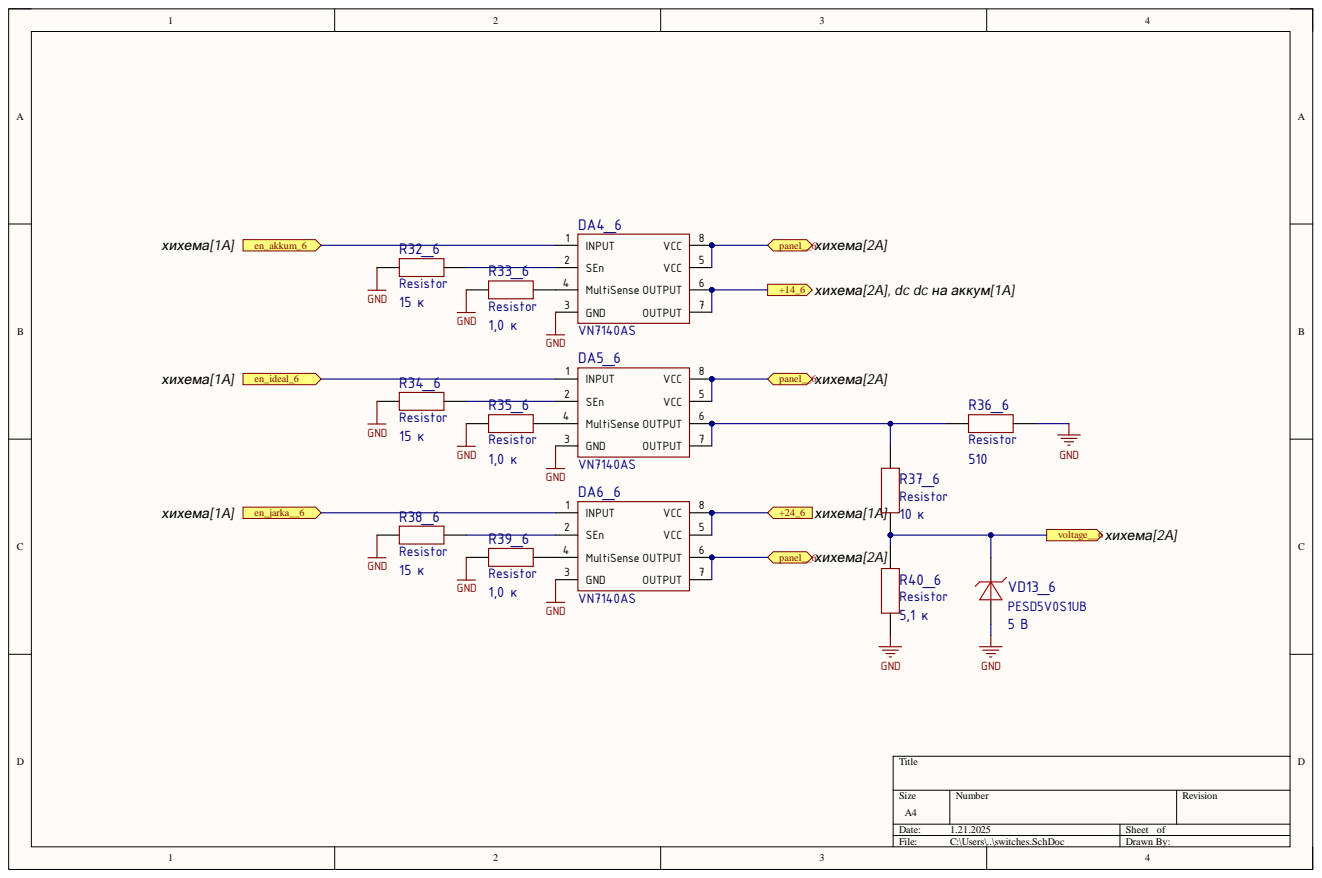
[picture p14: page 10]

+14_6 хихема[2A], dc dc на аккум[1A]

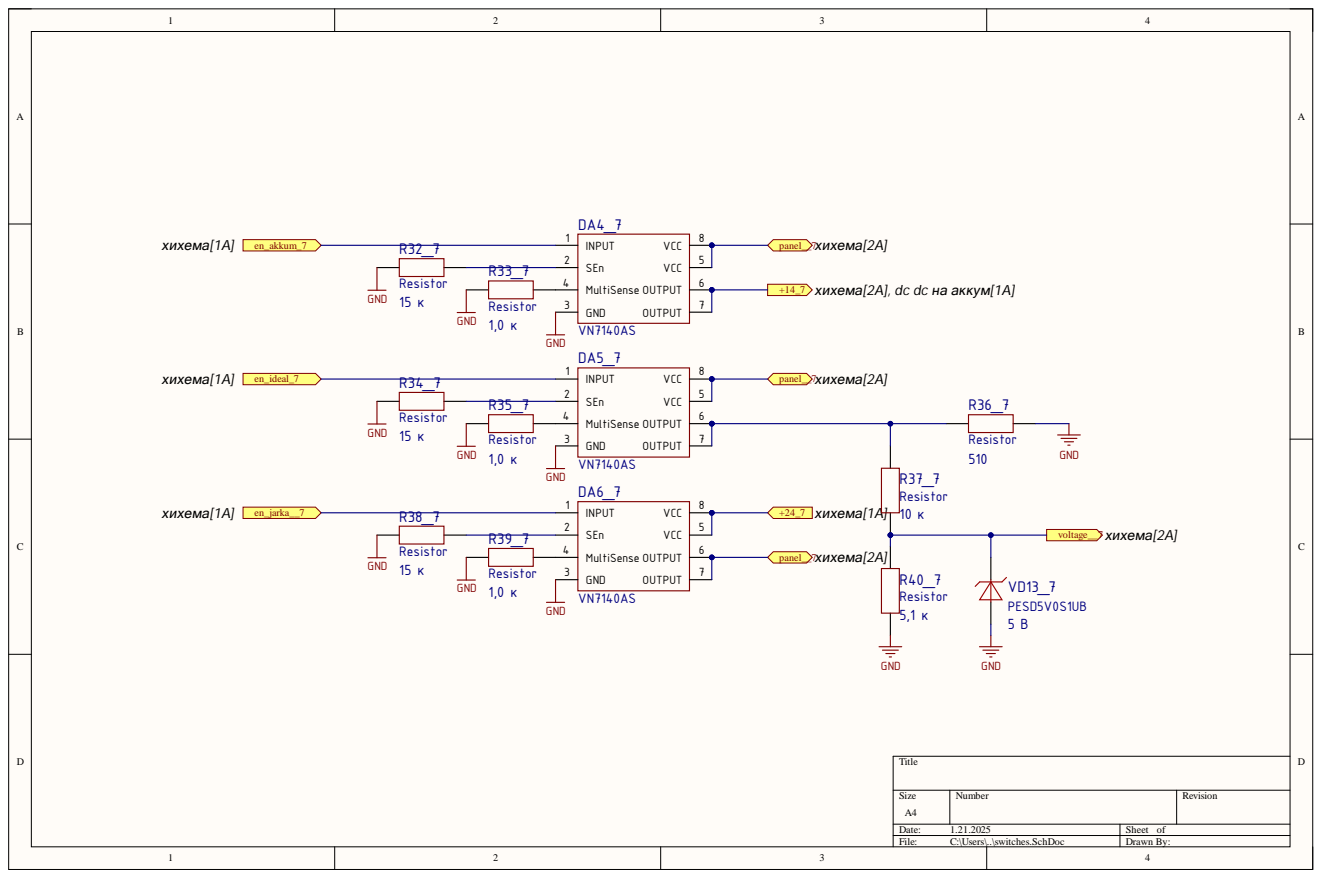
[picture p15: page 11]

+14_7 хихема[2A], dc dc на аккум[1A]

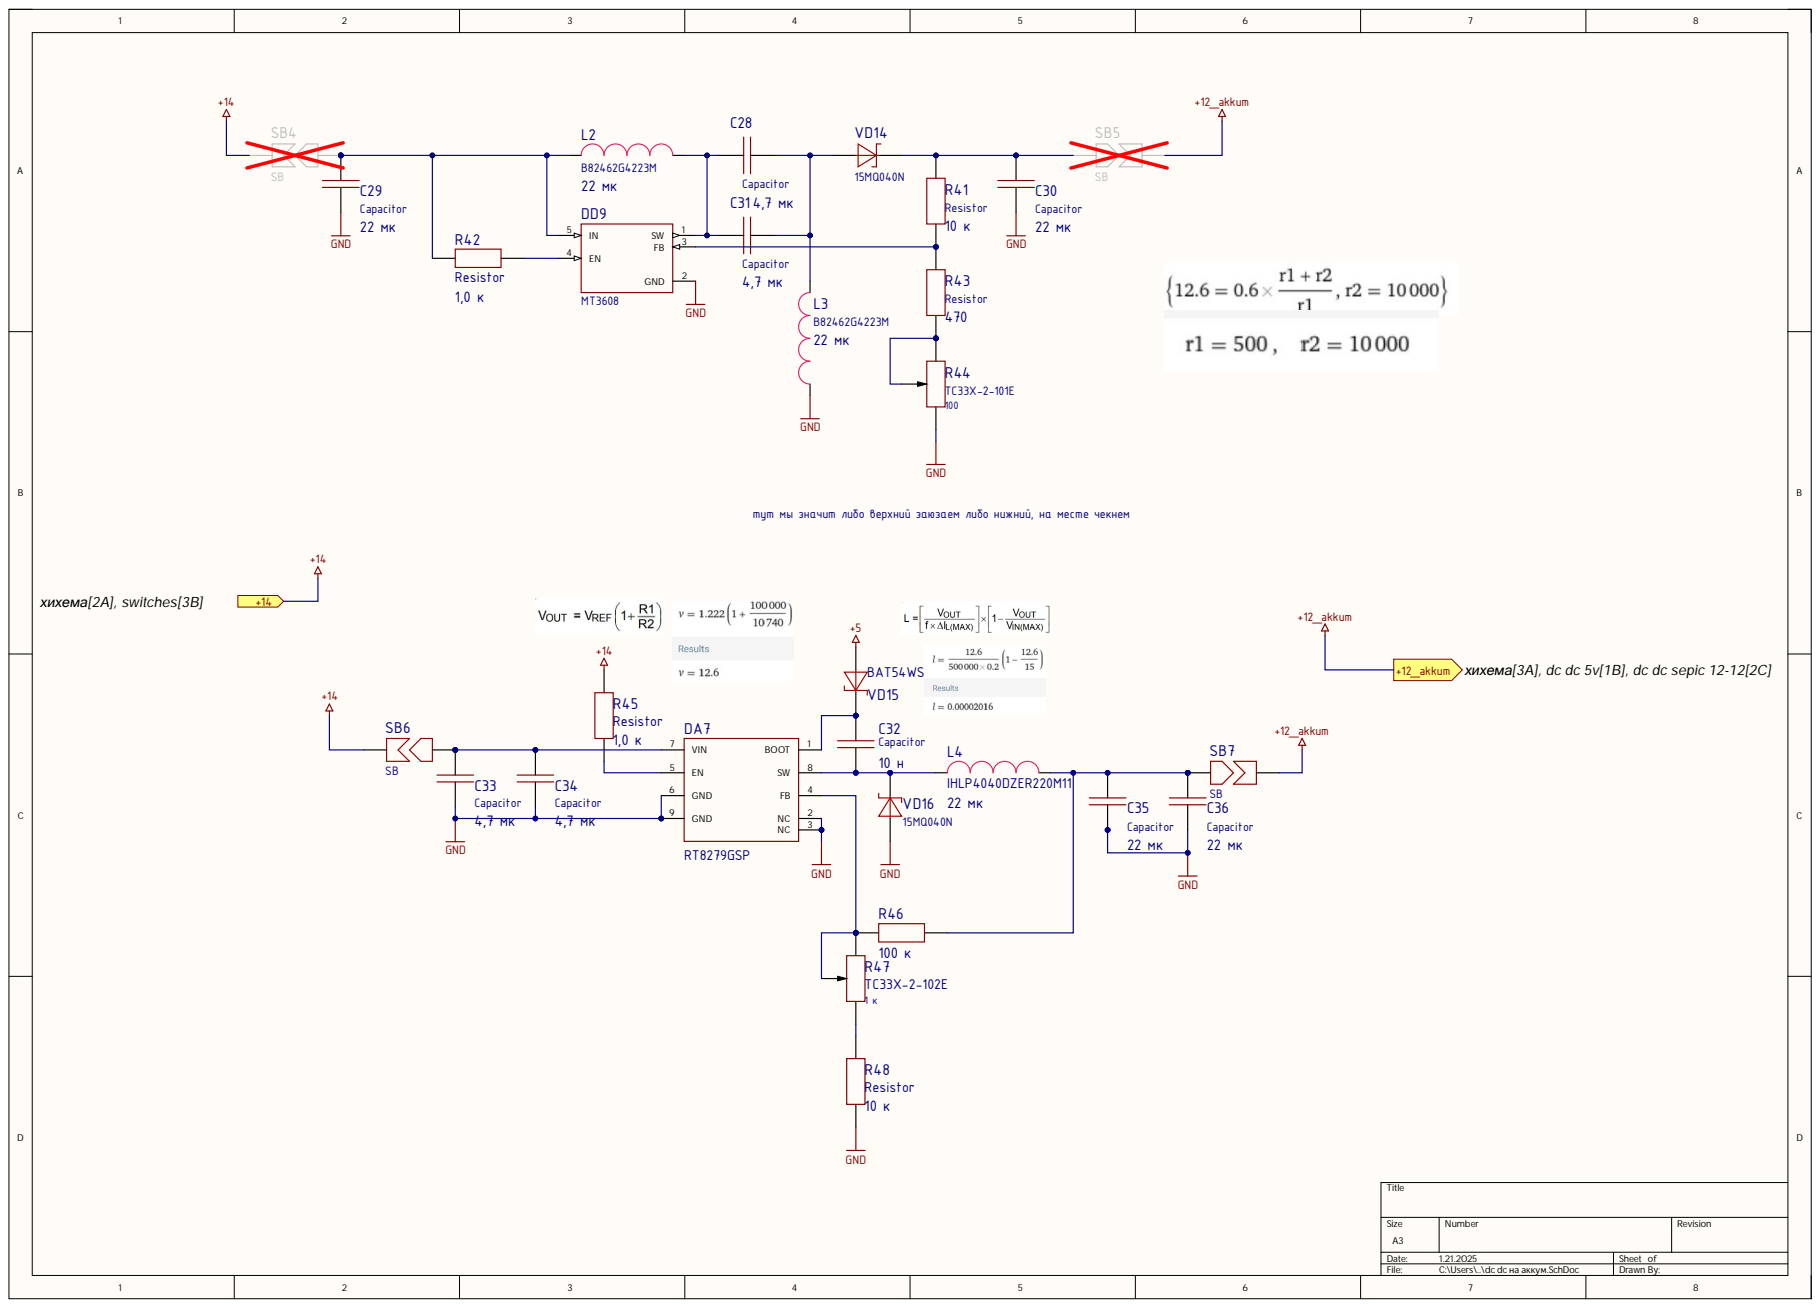
[picture p16: page 12]

тут мы значит либо верхний заюзаем либо нижний, на месте чекнем

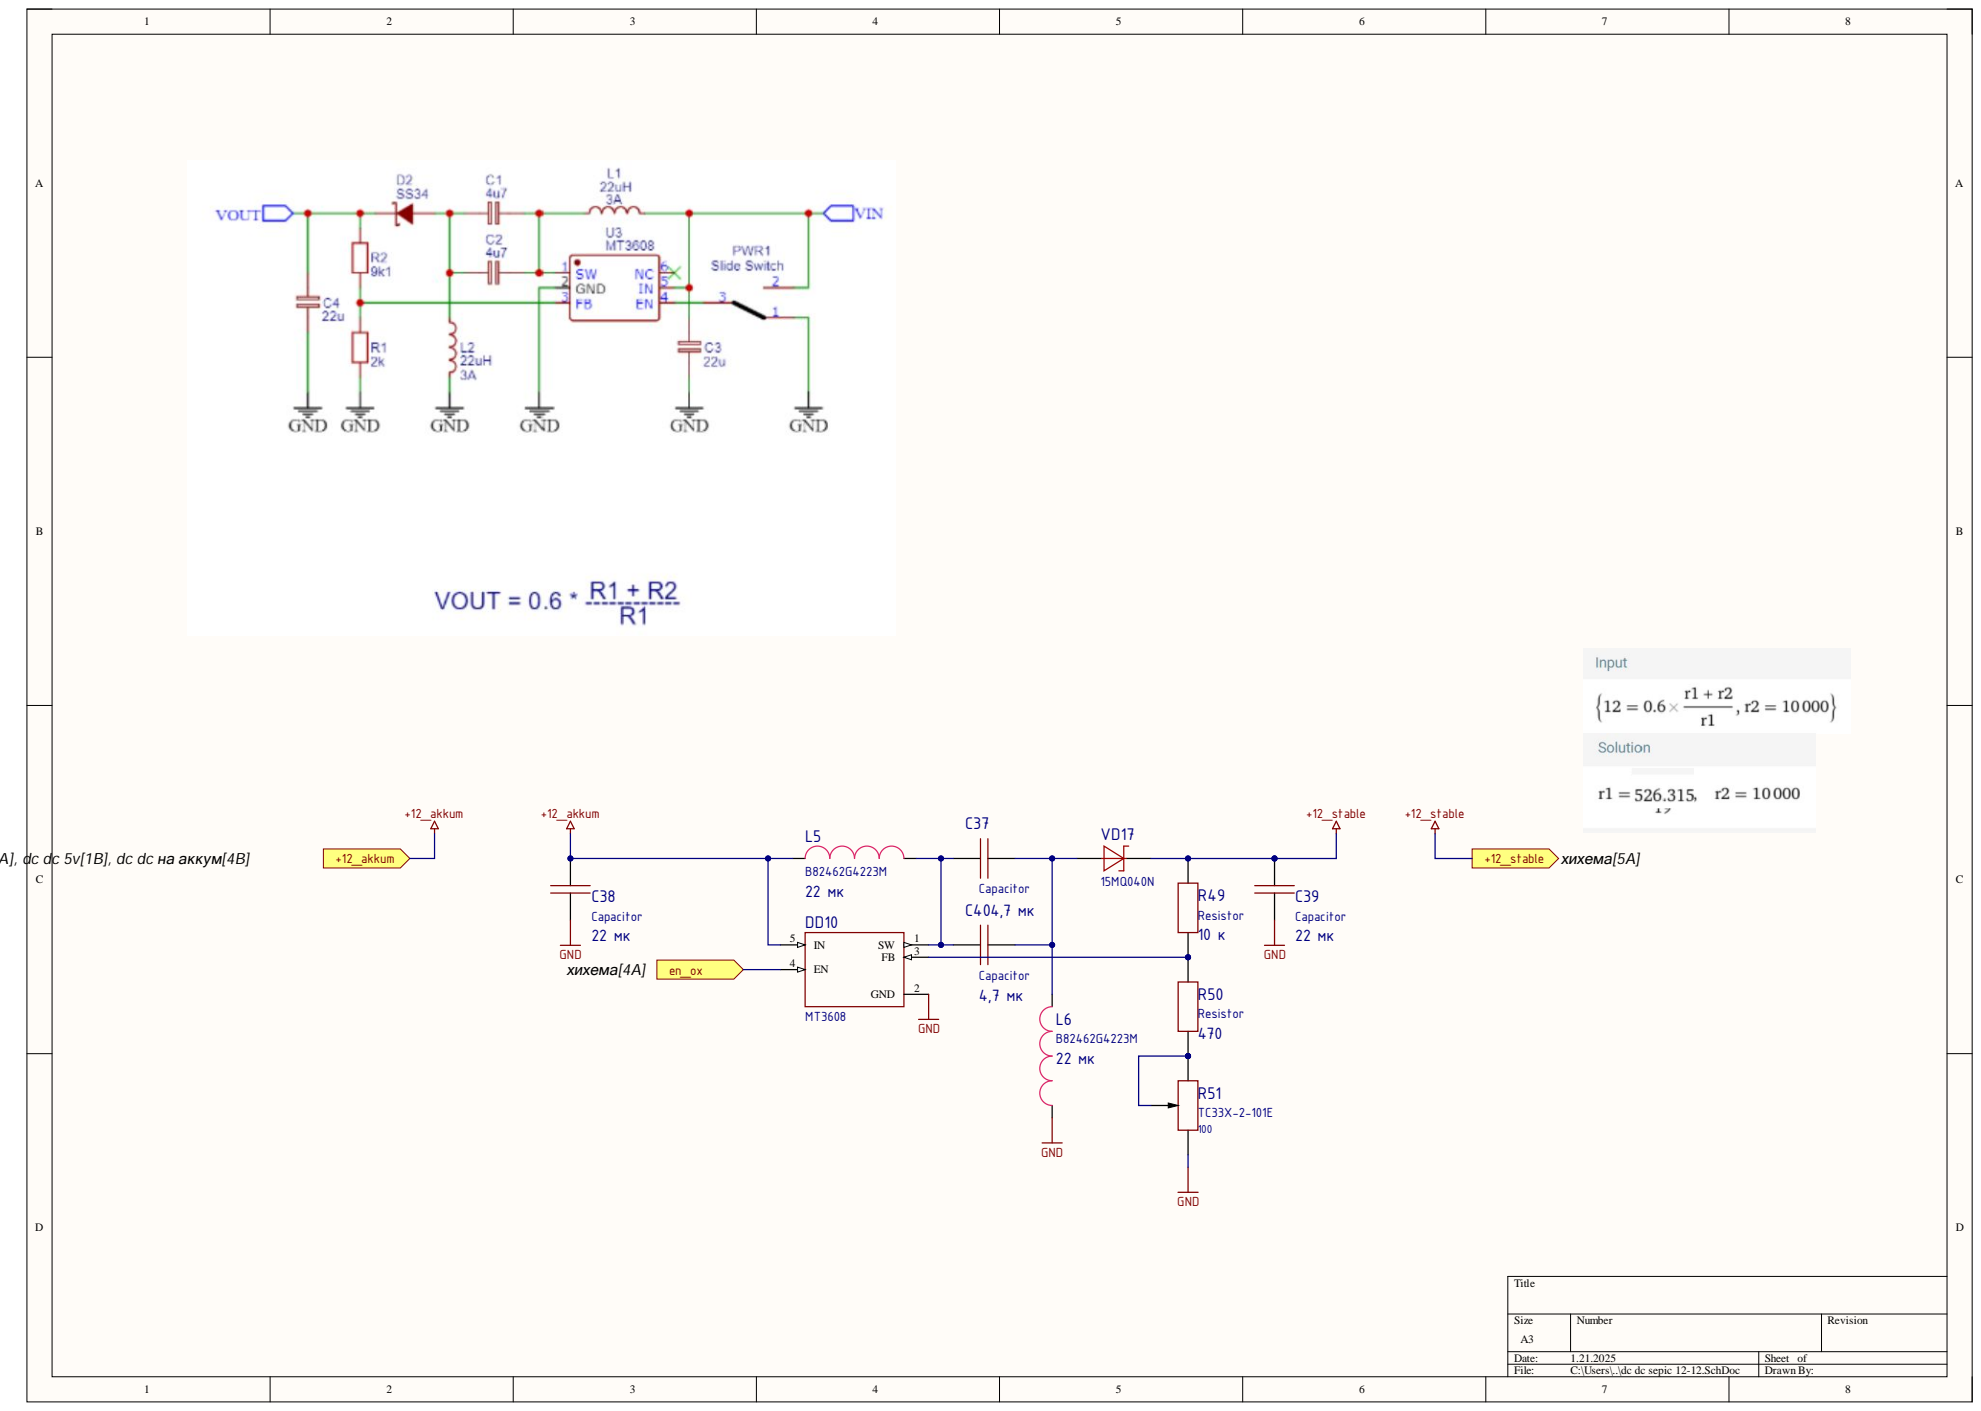
[picture p17: page 13]

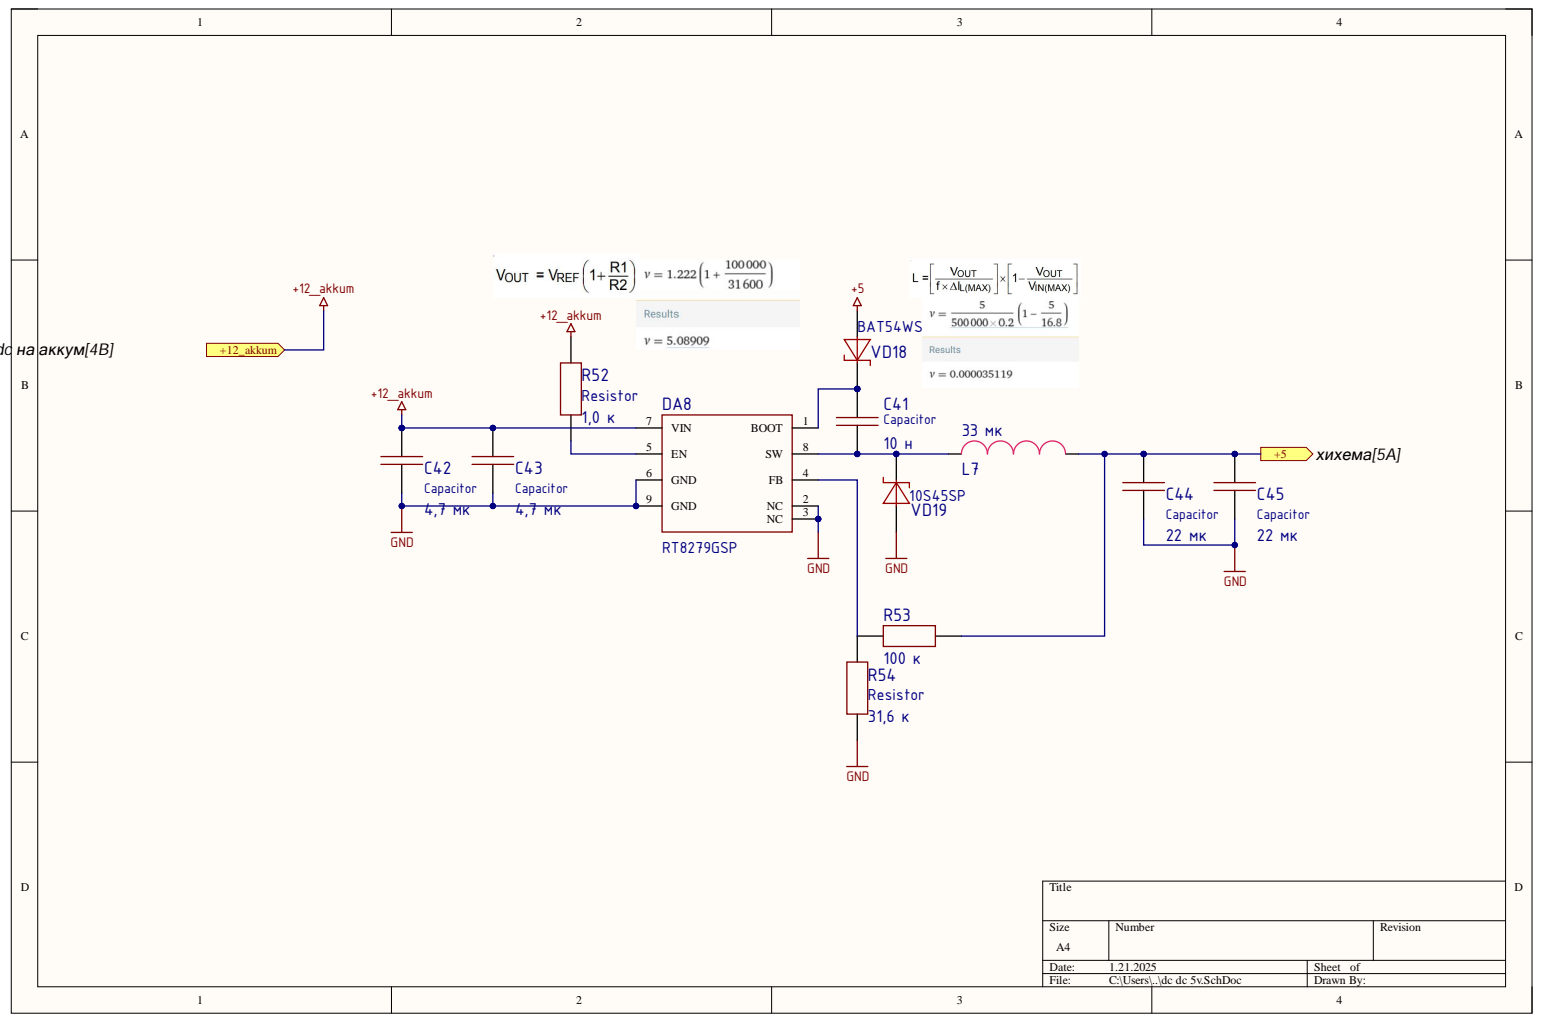
[picture p18: page 14]

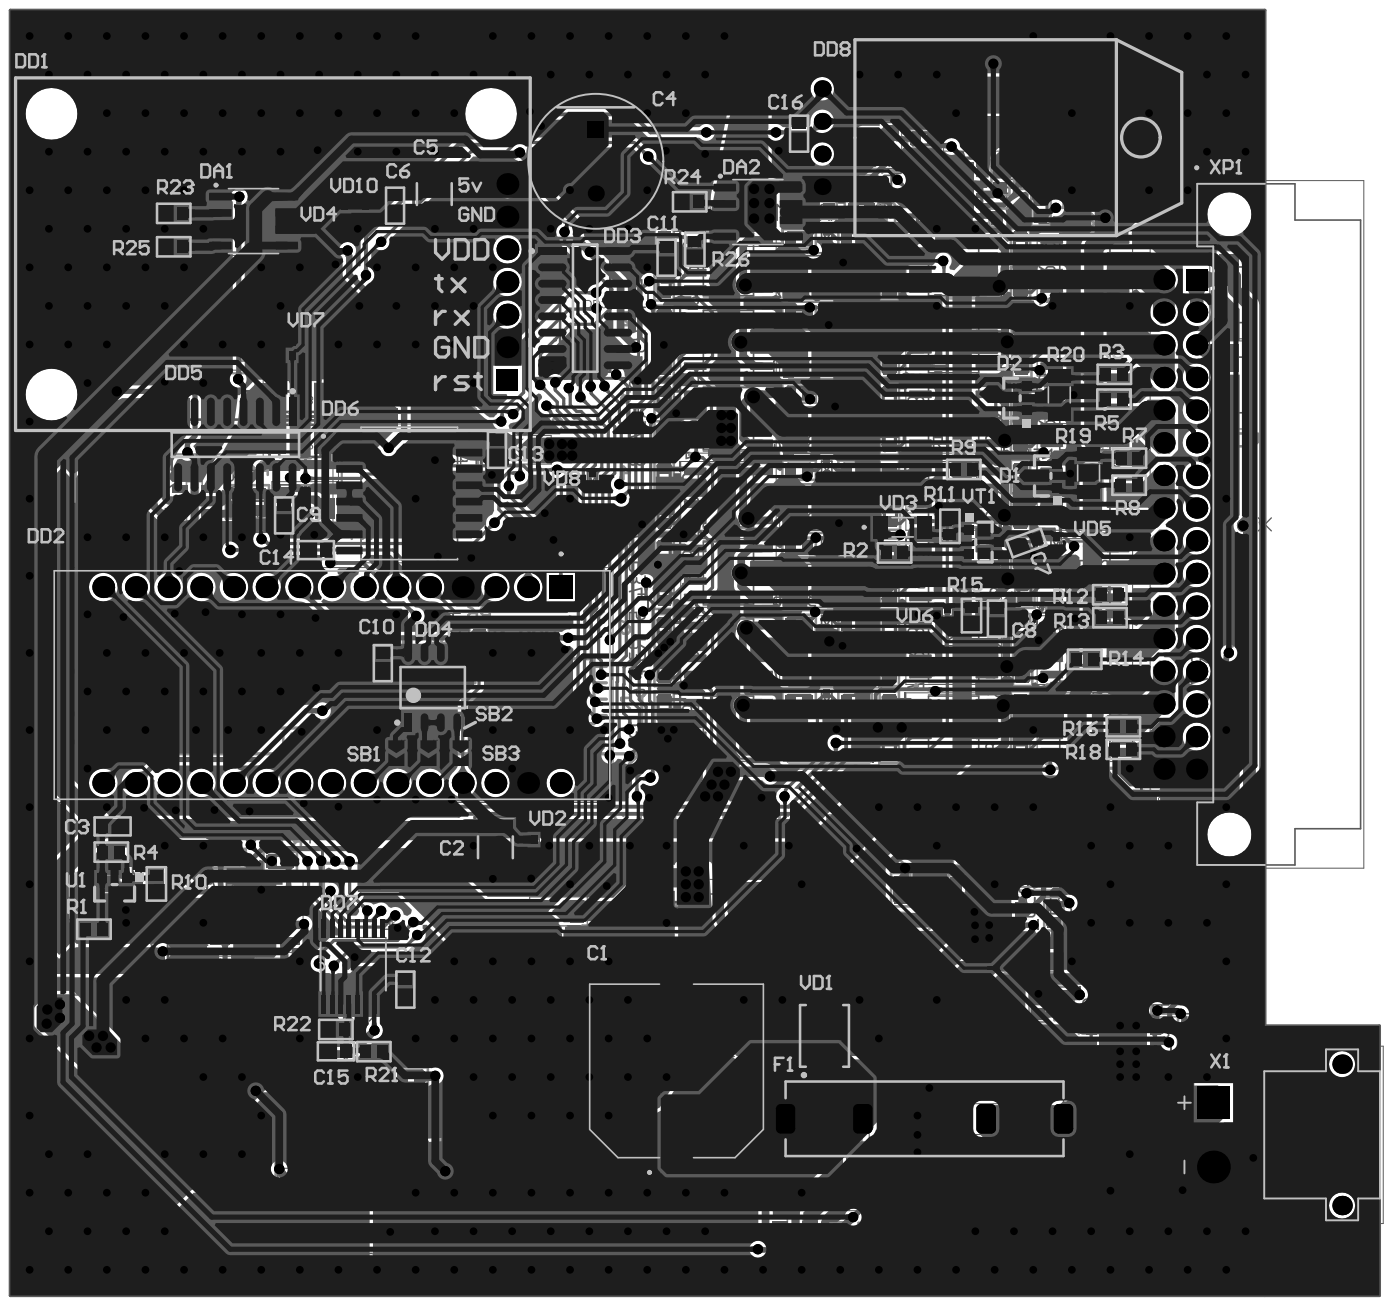
[picture p19: page 15]

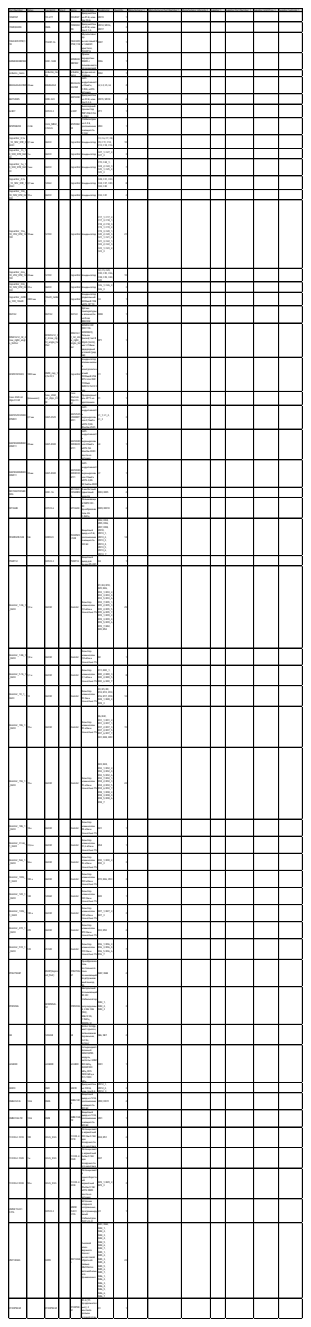
[picture p20: page 16]

15MQ040N | | SMA | 15MQ04 0N | Диод шоттки на 40 В, ном. ток 2.1 А | VD14, VD16, VD17 | 3

74HC4051PW,1 18 | | TSSOP-16 | 74HC405 1PW,118 | Мультиплекс ор аналоговый 8 в 1 КМОП кристалл, TSSOP16 | DD7 | 1

ADM2483BRWZ | | SOIC-16W | ADM248 3BRWZ | Прием передатчик RS485 с гальваническ ой развязкой | DD6 | 1

arduino_nano B82462G4223M | 22 мк | arduino_na no B82462G4 | arduino_ nano B82462G 4223M | ардуинка на стойках ЧИП-индуктивност ь 22мкГн, 1.05A, ±20% катушка | DD2 L2, L3, L5, L6 | 1 4

BAT54WS | | SOD-323 | BAT54W S | Диод шоттки на 30 В, ном. ток 0.2 А | VD15, VD18 | 2

bc807 | | SOT23-3 | bc807 | Биполярный транзистор PNP 45В 0.5А 0.31Вт | VT1 | 1

BZV55B2V4 | 2.4 В | mini_MELF_ 3.5mm | BZV55B2 V4 | Стабилитрон на 2.4 В, рассеиваема я мощность 0.5 Вт | VD3 | 1

Capacitor_0,1u _10_50V_X7R_0 603C | 0,1 мк | 0603C | Capacitor | Конденсатор | C3, C6, C7, C8, C9, C11, C12, C13, C14, C16 | 10

Capacitor_1n_1 0_50V_X7R_060 3C | 1 н | 0603C | Capacitor | Конденсатор | C27_1, C27_2, C27_3 | 3

Capacitor_1u_1 0_50V_X7R_060 3C | 1 мк | 0603C | Capacitor | Конденсатор | C15, C24_1, C24_2, C24_3, C25_1, C25_2, C25_3 | 7

Capacitor_4,7u _10_50V_X7R_1 206C | 4,7 мк | 1206C | Capacitor | Конденсатор | C28, C31, C33, C34, C37, C40, C42, C43 | 8

Capacitor_10n_ 10_50V_X7R_06 03C | 10 н | 0603C | Capacitor | Конденсатор | C32, C41 | 2

Capacitor_10u_ 10_35V_X7R_12 10C | 10 мк | 1210C | Capacitor | Конденсатор | C17_1, C17_2, C17_3, C18_1, C18_2, C18_3, C19_1, C19_2, C19_3, C20_1, C20_2, C20_3, C21_1, C21_2, C21_3, C22_1, C22_2, C22_3, C23_1, C23_2, C23_3 | 21

Capacitor_22u_ 10_25V_X7R_12 10C | 22 мк | 1210C | Capacitor | Конденсатор | C2, C5, C29, C30, C35, C36, C38, C39, C44, C45 | 10

Capacitor_33n_ 10_50V_X7R_06 03C | 33 н | 0603C | Capacitor | Конденсатор | C26_1, C26_2, C26_3 | 3

Capacitor_2200 u_10V_10x20 | 2200 мк | 10x20_radia l | Capacitor | Конденсатор радиальный 2200мкФ 10В ±20% 10*19 | C4 | 1

DHT22 | | DHT22 | DHT22 | Датчик температуры и влажности на базе AM2302 | DD8 | 1

DIN41612_32_2 row_right_angl e_father | | DIN41612_3 2_2row_rig ht_angle_fa ther | DIN4161 2_32_2ro w_right_ angle_fat her | DIN41612R (DS1118-32M0R23), Разъем (вилка) тип B 32pin (2х16), шаг 2.54мм двухрядный угловой (ряд АВ) | XP1 | 1

EEVFK1E102Q | 1000 мк | SMD_cap_1 2,5x13,5 | Capacitor | Конденсатор алюминиевы й электролитич еский 1000мкФ 25В 20% Low ESR 1100мА SMD12.5x13.5 мм | C1 | 1

Fuse 20x5 on clips FC-M | {Номинал} | fuse_20x5_ on_clips_FC-M | Fuse 20x5 on clips FC-M | Предохранит ель 20*5 на креплениях | F1 | 1

IHLP2525CZER4 R7M01 | 4,7 мк | IHLP-2525 | IHLP2525 CZER4R7 M01 | ЧИП-индуктивност ь экранирован ная 4,7мкГн ±20% 5,5A 40мОм 2525 | L1_1, L1_2, L1_3 | 3

IHLP4040DZER2 20M11 | 22 мк | IHLP-4040 | IHLP4040 DZER220 M11 | ЧИП-индуктивност ь экранирован ная 22мкГн ±20% 5A 66мОм 4040 лента на катушке | L4 | 1

IHLP4040DZER3 30M11 | 33 мк | IHLP-4040 | IHLP4040 DZER330 M11 | ЧИП-индуктивност ь экранирован ная 33мкГн ±20% 4,4A 94,5мОм 4040 | L7 | 1

MC74HC595AD R2G | | SOIC-16 | MC74HC 595ADR2 G | 8-ми битный сдвиговый регистр | DD3, DD5 | 2

MT3608 | | SOT23-6 | MT3608 | Повышающи й/SEPIC DC-DC преобразова тель 2А 1.2МГц | DD9, DD10 | 2

PESD5V0S1UB | 5 В | SOD523 | PESD5V0 S1UB | Защитный диод на 5 В, рассеиваема я мощность 330 Вт | VD2, VD4, VD5, VD6, VD7, VD8, VD10, VD13_1, VD13_2, VD13_3, VD13_4, VD13_5, VD13_6, VD13_7 | 14

PSM712 | | SOT23-3 | PSM712 | Защитный диод для линии RS-485 | D2 | 1

Resistor_1.0k_1 _0603 | 1,0 к | 0603R | Resistor | Резистор номиналом 1,0 кОм и точностью 1% | R1, R4, R10, R25, R26, R33_1, R33_2, R33_3, R33_4, R33_5, R33_6, R33_7, R35_1, R35_2, R35_3, R35_4, R35_5, R35_6, R35_7, R39_1, R39_2, R39_3, R39_4, R39_5, R39_6, R39_7, R42, R45, R52 | 29

Resistor_1.8k_1 _0603 | 1,8 к | 0603R | Resistor | Резистор номиналом 1,8 кОм и точностью 1% | R2 | 1

Resistor_5.1k_1 _0603 | 5,1 к | 0603R | Resistor | Резистор номиналом 5,1 кОм и точностью 1% | R11, R40_1, R40_2, R40_3, R40_4, R40_5, R40_6, R40_7 | 8

Resistor_10_1_ 0603 | 10 | 0603R | Resistor | Резистор номиналом 10 Ом и точностью 1% | R3, R5, R9, R12, R13, R14, R16, R17, R18, R28_1, R28_2, R28_3 | 12

Resistor_10k_1 _0603 | 10 к | 0603R | Resistor | Резистор номиналом 10 кОм и точностью 1% | R6, R22, R31_1, R31_2, R31_3, R37_1, R37_2, R37_3, R37_4, R37_5, R37_6, R37_7, R41, R48, R49 | 15

Resistor_15k_1 _0603 | 15 к | 0603R | Resistor | Резистор номиналом 15 кОм и точностью 1% | R23, R24, R32_1, R32_2, R32_3, R32_4, R32_5, R32_6, R32_7, R34_1, R34_2, R34_3, R34_4, R34_5, R34_6, R34_7, R38_1, R38_2, R38_3, R38_4, R38_5, R38_6, R38_7 | 23

Resistor_18k_1 _0603 | 18 к | 0603R | Resistor | Резистор номиналом 18 кОм и точностью 1% | R21 | 1

Resistor_31.6k_ 1_0603 | 31,6 к | 0603R | Resistor | Резистор номиналом 31,6 кОм и точностью 1% | R54 | 1

Resistor_56k_1 _0603 | 56 к | 0603R | Resistor | Резистор номиналом 56 кОм и точностью 1% | R30_1, R30_2, R30_3 | 3

Resistor_100k_ 1_0603 | 100 к | 0603R | Resistor | Резистор номиналом 100 кОм и точностью 1% | R15, R46, R53 | 3

Resistor_120_1 _0603 | 120 | 1206R | Resistor | Резистор номиналом 120 Ом и точностью 1% | R20 | 1

Resistor_130k_ 1_0603 | 130 к | 0603R | Resistor | Резистор номиналом 130 кОм и точностью 1% | R27_1, R27_2, R27_3 | 3

Resistor_470_1 _0603 | 470 | 0603R | Resistor | Резистор номиналом 470 Ом и точностью 1% | R43, R50 | 2

Resistor_510_1 _0603 | 510 | 2512R | Resistor | Резистор номиналом 510 Ом и точностью 1% | R36_1, R36_2, R36_3, R36_4, R36_5, R36_6, R36_7 | 7

RT8279GSP | | 8SOP(Expos ed_Pad) | RT8279G SP | Преобразова тель постоянного тока понижающий подстраивае мый выход 5А | DA7, DA8 | 2

RT8509A | | WDFN5x5-12 | RT8509A | Импульсный повышающий DC-DC стабилизатор , регулируемы й, 2.8В-14В (Vin), 24В/4.5A, 1.5МГц, WDFN-12 | DA3_1, DA3_2, DA3_3 | 3

SB | | 1206SB | SB | Solder bridge, мост припоя, запаиваемая перемычка, jumper net tie, | SB6, SB7 | 2

sim800l | | sim800l | sim800l | Четырехдиап азонный GSM/GPRS модуль, частоты: GSM 850 МГц, EGSM 900 МГц, DCS 1800 МГц и PCS 1900 МГц. | DD1 | 1

SK810 | | SMC | SK810 | Диод шоттки на 100 В, ном. ток 8 А | VD12_1, VD12_2, VD12_3 | 3

SMAJ12CA | 12 В | SMA | SMAJ12C A | Защитный диод на 12 В, рассеиваема я мощность 400 Вт | VD9, VD11 | 2

SMBJ13A-TR | 13 В | SMB | SMBJ13A-TR | Защитный диод на 13 В, рассеиваема я мощность 600 Вт | VD1 | 1

TC33X-2-101E | 100 | 3mm_trim | TC33X-2-101E | Потенциомет р керметный 100 Ом 0.1Вт для поверхностн ого монтажа | R44, R51 | 2

TC33X-2-102E | 1 к | 3mm_trim | TC33X-2-102E | Потенциомет р керметный 1кОм 0.1Вт для поверхностн ого монтажа | R47 | 1

TC33X-2-503E | 50 к | 3mm_trim | TC33X-2-503E | Потенциомет р однооборотн ый керметный 50кОм 0.1Вт ±25% SMD лента на катушке | R29_1, R29_2, R29_3 | 3

UMW TL431 0.5% | | SOT23-3 | UMW TL431 0.5% | Источник опорного напряжения , программиру емый стабилитрон [SOT-23-3] | U1 | 1

VN7140AS | | SOP8 | VN7140A S | Силовой ключ верхнего плеча с аналоговой обратной связью MultiSense автомобильн ого применения | DA1, DA2, DA4_1, DA4_2, DA4_3, DA4_4, DA4_5, DA4_6, DA4_7, DA5_1, DA5_2, DA5_3, DA5_4, DA5_5, DA5_6, DA5_7, DA6_1, DA6_2, DA6_3, DA6_4, DA6_5, DA6_6, DA6_7

XT30PW-M | | XT30PW-M | XT30PW-M | 30 А (15 продолжител ьно), 2 контакта разъем угловой отец | X1 | 1
