cavesLezet/buoy_v2/слои.pdf

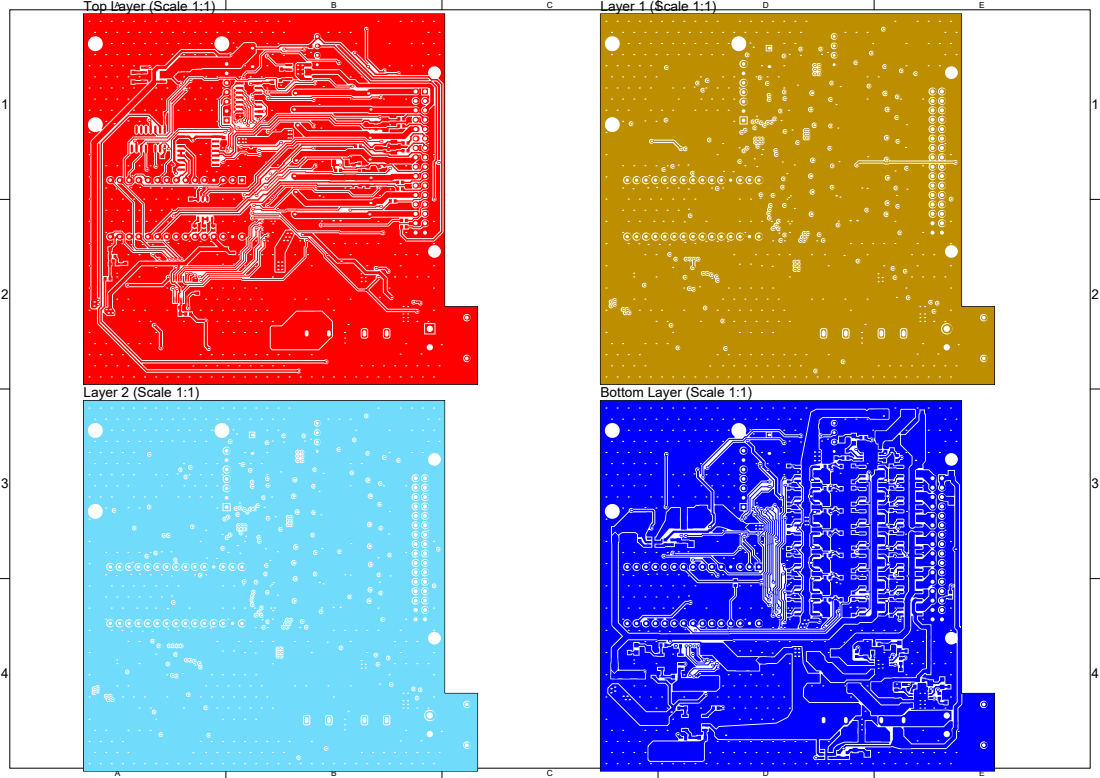
[picture p21: page 1]
Top Layer (Scale 1:1); Layer 1 (Scale 1:1); Layer 2 (Scale 1:1); Bottom Layer (Scale 1:1)
