cavesLezet/buoy_v2/моделирование источника тока на тл431/tl431-PSpiceFiles/SCHEMATIC1/tl431/tl431.cir

** Profile: "SCHEMATIC1-tl431"  [ C:\Users\shustrik\Documents\Altium\buoy_v2\моделирование источника тока на тл431\tl431-PSpiceFiles\SCHEMATIC1\tl431.sim ] 

** Creating circuit file "tl431.cir" 
** WARNING: THIS AUTOMATICALLY GENERATED FILE MAY BE OVERWRITTEN BY SUBSEQUENT SIMULATIONS

*Libraries: 
* Profile Libraries :
* Local Libraries :
* From [PSPICE NETLIST] section of C:\Users\shustrik\AppData\Roaming\SPB_Data\cdssetup\OrCAD_PSpice\23.1.0\PSpice.ini file:
.lib "nom.lib" 

*Analysis directives: 
.TRAN  0 1ms 0 10u 
.OPTIONS ADVCONV
.PROBE64 V(alias(*)) I(alias(*)) W(alias(*)) D(alias(*)) NOISE(alias(*)) 
.INC "..\SCHEMATIC1.net" 


.END
