cavesLezet/buoy_v2/(list of files, drawings)

Other design files:
buoy_v2.0_AA.PrjPcb
dc dc 5v.SchDoc
dc dc sepic 12-12.SchDoc
dc dc жарить панели.SchDoc
dc dc на аккум.SchDoc
switches.SchDoc
библиотеки/ARDUINO_NANO/SHIELD_ARDUINO_NANO.PcbLib
моделирование заряда затвора/gate_charge.dsn
моделирование заряда затвора/gate_charge.opj
моделирование источника тока на тл431/tl431.dsn
моделирование источника тока на тл431/tl431.opj
хихема.SchDoc
