cavesLezet/buoy_v2/(commit log)

2024-11-28 init commit
    [ARDUINO_NANO.SchLib, CAPPRD500W60D1350H2200.PcbLib, CONV_P7805-500.PcbLib, Components - esd protect.PcbLib, Components - esd protect.SchLib, Components - klemmnik.PcbLib, Components - klemmnik.SchLib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]
2024-12-02 чето сделал
    [ARDUINO_NANO.SchLib, dcdc5v.SchDoc, jarit'_paneli.SchDoc, буй_2_0_AA.PrjPcb, хехема.SchDoc]
2024-12-03 добавил 2 листа
    [dcdc_na_akkum.SchDoc, switch.SchDoc, буй_2_0_AA.PrjPcb, хехема.SchDoc]
2024-12-05 чето еще сделал
    [dcdc5v.SchDoc, dcdc_na_akkum.SchDoc, jarit'_paneli.SchDoc, switch.SchDoc, буй_2_0_AA.PrjPcb, хехема.SchDoc]
2024-12-11 чето добавил
    [dcdc5v.SchDoc, dcdc_na_akkum.SchDoc, jarit'_paneli.SchDoc, хехема.SchDoc]
2024-12-12 чето поправил
    [Components - cap 10X20.PcbLib, Components - cap 10X20.SchLib, Components - fuse.PcbLib, Components - fuse.SchLib, dcdc5v.SchDoc, dcdc_na_akkum.SchDoc, jarit'_paneli.SchDoc, switch.SchDoc]
2024-12-15 добавил симуляцию
    [tl431.dsn, tl431.opj]
2024-12-16 сделал симуляцию
    [tl431.dsn, tl431.opj]
2024-12-16 добавил источник тока и еще чето
    [dcdc5v.SchDoc, dcdc_na_akkum.SchDoc, jarit'_paneli.SchDoc, switch.SchDoc, буй_2_0_AA.PrjPcb, хехема.SchDoc]
2024-12-16 добавил тмп36 и по мелочи твс диодов, кондеров
    [буй_2_0_AA.PrjPcb, хехема.SchDoc]
2024-12-16 и пдфку
2024-12-17 добавил влажный и sepic dc dc, а так же по мелочи хуйню
    [dcdc5v.SchDoc, dcdc_na_akkum.SchDoc, jarit'_paneli.SchDoc, sepic12-12.SchDoc, switch.SchDoc, буй_2_0_AA.PrjPcb, хехема.SchDoc]
2024-12-18 в прошлом коммите разводить начал и ещё чёто по мелочи
2024-12-19 добавил дин, резисторов третий дцшник
    [dcdc5v.SchDoc, dcdc_na_akkum.SchDoc, jarit'_paneli.SchDoc, sepic12-12.SchDoc, switch.SchDoc, буй_2_0_AA.PrjPcb, хехема.SchDoc]
2024-12-20 полностью заменил проект, чтобы комнаты запилить
    [ARDUINO_NANO.SchLib, CAPPRD500W60D1350H2200.PcbLib, CONV_P7805-500.PcbLib, Components - cap 10X20.PcbLib, Components - cap 10X20.SchLib, Components - esd protect.PcbLib, Components - esd protect.SchLib, Components - fuse.PcbLib]
2025-01-10 начал разводку
    [buoy_v2.0_AA.PrjPcb, dc dc 5v.SchDoc, dc dc sepic 12-12.SchDoc, dc dc жарить панели.SchDoc, dc dc на аккум.SchDoc, switches.SchDoc, хихема.SchDoc]
2025-01-15 доразвёл
    [buoy_v2.0_AA.PrjPcb, dc dc 5v.SchDoc, dc dc sepic 12-12.SchDoc, dc dc жарить панели.SchDoc, dc dc на аккум.SchDoc, хихема.SchDoc]
2025-01-17 заказал
    [buoy_v2.0_AA.PrjPcb, dc dc sepic 12-12.SchDoc, dc dc жарить панели.SchDoc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]
2025-01-20 добавил комментов
    [buoy_v2.0_AA.PrjPcb, buoy_v2.0_AA.xlsx, dc dc жарить панели.SchDoc]
2025-06-23 моделил мосфет для мт3608
    [gate_charge.dsn, gate_charge.opj]
